JulienChagnon/C5VRX/README.md

<div align="center">
  C5VRX animated logo

  <p><strong>ESP32-C5 Analog 5.8 GHz FPV Receiver</strong></p>
  <p>From live 5.8 GHz FPV video to real-time analog CVBS with one Seeed Studio XIAO ESP32-C5 and a passive resistor DAC.</p>

  <p>
    
    
    
    
    
    
    
    
  </p>

  <p>
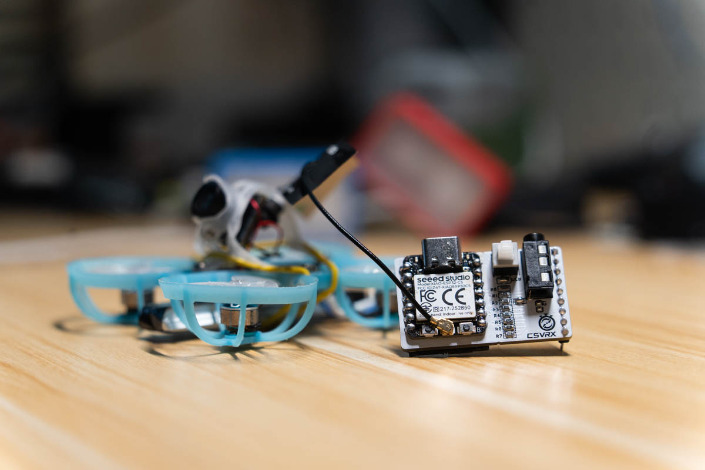
[picture p1: assets/C5VRX-1.jpg]
C5VRX receiver module with micro drone
    
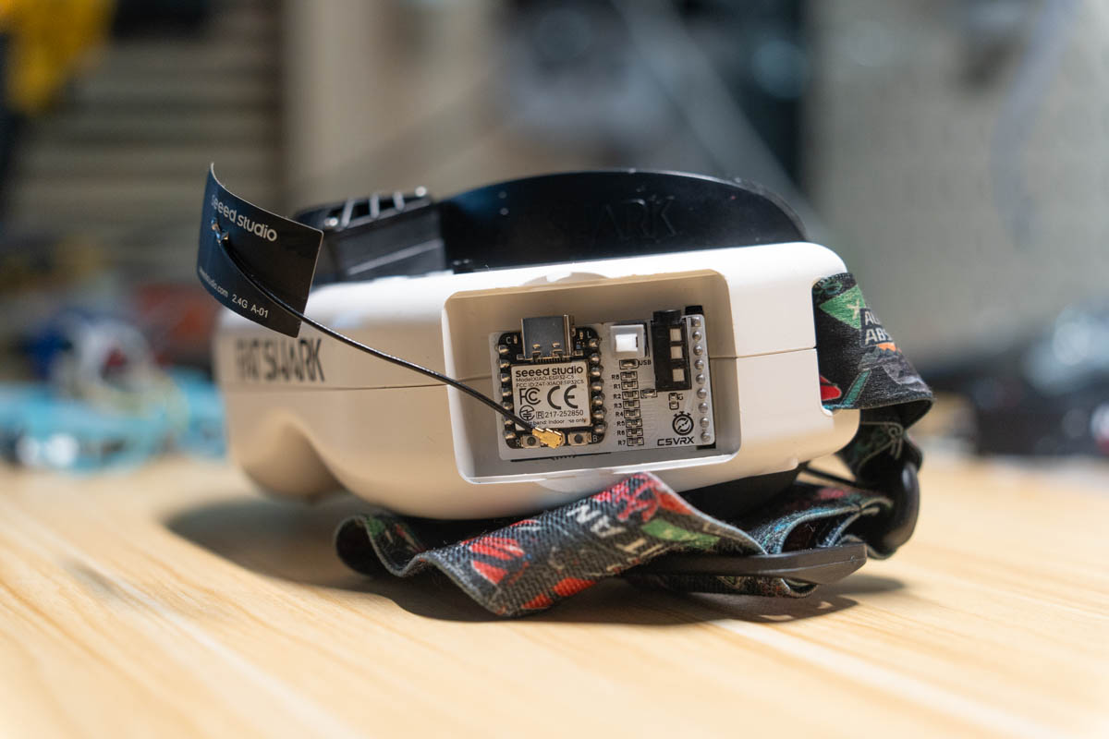
[picture p2: assets/C5VRX-2.jpg]
C5VRX receiver module installed in Fat Shark goggles
    
  </p>
</div>

---

C5VRX-5 receives analog 5.8 GHz FPV video using the ESP32-C5's own radio
and outputs composite PAL/NTSC through a passive 6-bit resistor DAC.
It includes automatic gain control, quick baseline boot and manual calibration, an on-screen menu
and browser-based flashing and controls. The sync flywheel was removed on
2026-10-25 (it caused severe desyncs and poor range on the board).

This branch builds and boots **U80P64-R1 only**. U85Q, kp/LP switching and
`m/K/k/j/P/O/H` controls are retired; see [P64 integration and evidence](docs/P64.md).
The fixed R1 table has one positive NTSC observation; PAL, weak-signal/range
and the final cleanup still need hardware validation. This default is an
operator choice, not a hardware qualification claim.

The PR #254 **11p receive baseline** is now applied at startup and after
channel/bandwidth/AFC restores, before measured analog profiles and digital
mode 0. In this branch calibration is manual; a quick boot phase check and
passive health monitor may recommend CALIBRATE. Upgrades can invalidate older
tables without starting an automatic calibration. The noise-only bench result is not a measured
sensitivity/range gain; see [11p integration and limits](docs/FINDINGS.md#11p-receive-baseline-pr-254-integration-2026-10-24).

## Experimental firmware — flight safety warning

> [!WARNING]
> **C5VRX is an experimental FPV receiver. Bugs, signal loss, automatic
> receive-chain changes or incompatibility with your camera/goggles can cause
> sudden loss of video or sync, even after an apparently successful test.
> Loss of FPV video can lead to a crash, property damage or serious injury.**
> Do not rely on C5VRX as your only means of maintaining safe control of an aircraft.

- **Test every new firmware version and hardware/settings combination on the
  ground first.** Remove propellers for bench tests. Check startup and
  calibration, weak-signal behaviour, recovery after video loss, and your actual
  camera/goggles. Complete calibration before takeoff.
- **Keep disruptive controls on the ground:** calibration, scanning, channel
  changes, menu entry/exit, DAC tests and diagnostics can interrupt or replace
  the live picture. Do not flash firmware or run bench tests during flight.
- **Automatic changes are experimental too.** Live filter/profile switching is
  currently documented as enabled by default and awaiting board validation.
  It restarts part of the receive chain and may interrupt video. Console
  `A` disables live profile switching (report-only mode); confirm the state
  with `T` on your build. Live OUTPUT, format and profile changes restart the pipeline. These settings do not establish flight safety.
- If you proceed to flight testing, use a controlled area clear of people,
  traffic and property, keep the aircraft close, and have a safe way to recover
  control if video disappears. Follow applicable local rules, including visual
  line-of-sight and observer requirements.
- **A versioned release, a “Latest” label or passing CI is not flight
  qualification.** Unmerged PR builds are development builds. Check the exact
  build's documented hardware and flight-test evidence; a test of an earlier
  build does not validate later changes.
- Report unexpected video loss with the exact firmware version/commit, hardware,
  settings, reproduction steps and any available logs/DVR footage. Preserve
  evidence after an incident, and investigate on the ground before flying again.

The firmware is provided under [GPL-3.0-only](LICENSE), including its warranty
and liability provisions in sections 15–17, to the extent permitted by
applicable law. This warning does not replace those terms or limit rights
that cannot legally be excluded.

## Video

[Watch the C5VRX-5 vs C5VRX-4 flight range test by Louis Hitchcock](https://www.youtube.com/watch?v=Gp3xmLrn_34).

## Hardware

XIAO ESP32-C5. DAC on D4..D9 (GPIO 23, 24, 11, 12, 8, 9; LSB first) with
8.2k / 3.9k / 2k / 1k / 470R / 240R and a 200R load, as in C5VRX-3/4
([schematic](docs/hardware/c5vrx-dac-schematic.png)). The
receiver uses the ESP32-C5's own Wi-Fi radio; no extra RF parts.

Other ESP32-C5 boards (Espressif DevKitC-1, Waveshare ESP32-C5-Pico, NiceMCU
ESP32-C5 Mini) have their own pin maps and images, and any other ESP32-C5
board can be flashed with its own pins from the web flasher's pin editor.
None of them is tested on hardware yet. The flasher draws each board with
the resistor for every pin. See [Boards](docs/BOARDS.md).

This development build moves the internal I-LSB loopback from D10/GPIO10
to the user-LED GPIO27, and the Q-sign loopback from D3/GPIO7 to GPIO2.
This reserves **D10 and D3 for future seventh/eighth DAC branches**. The LED
may glow during reception. No external IQ wiring is needed; the active DAC
remains 6-bit and the extra resistor footprints must stay **unpopulated (DNP)**.

| Reserved extra branch | XIAO pin / GPIO | Nominal resistor to CVBS | Future significance |
| --- | --- | --- | --- |
| Seventh branch | D10 / GPIO10 | 15 kOhm | 7-bit: bit 0; 8-bit: bit 1 |
| Eighth branch | D3 / GPIO7 | 33 kOhm | 8-bit: bit 0 (LSB) |

“Seventh/eighth” counts physical branches; these are added **low** bits,
not new MSBs. Existing D4..D9 branches become bits 1..6 for 7-bit or 2..7
for 8-bit. These are reserved footprints, not enabled output lanes or a
validated 7/8-bit resistor network. Wider output needs firmware and loaded
CVBS level/linearity checks. D3/GPIO7 is a boot strap: check reset loading
before populating its branch. GPIO2 is now IQ-owned and cannot also carry
the optional sample clock from PR #257. Both new IQ routes still require
board validation. The operator reported unsatisfactory behavior with the
LED-pin IQ route; this PR isolates it for comparison, not hardware acceptance.
See [the pin-routing findings](docs/FINDINGS.md#gpio27-iq-loopback-experiment-2026-10-25).

### Wiring the resistor DAC

Six resistors, one per XIAO pin, all joined on one node: that node is the
video output (CVBS). A seventh resistor from that node to GND is the load.

| XIAO pin | GPIO | DAC bit | resistor to the output node |
| --- | ---: | --- | ---: |
| D4 | 23 | bit 0 (LSB) | 8.2 kΩ |
| D5 | 24 | bit 1 | 3.9 kΩ |
| D6 | 11 | bit 2 | 2.0 kΩ |
| D7 | 12 | bit 3 | 1.0 kΩ |
| D8 | 8 | bit 4 | 470 Ω |
| D9 | 9 | bit 5 (MSB) | 240 Ω |
| GND | - | load | 200 Ω (output node to GND) |

```
D4 --[8.2k]--+
D5 --[3.9k]--+
D6 --[2.0k]--+
D7 --[1.0k]--+-----------> CVBS out (goggle / monitor AV-in, video)
D8 --[470R]--+     |
D9 --[240R]--+   [200R]   (optional: 470 pF from the node to GND,
                   |        improvement unproven)
GND ---------------+------> GND (goggle / monitor AV-in ground)
```

- The pin order matters: the largest resistor (8.2k) goes on D4 and the
  smallest (240R) on D9. A swapped pair gives a scrambled, banded picture.
- Connect the output node to the video input (centre/tip) of the goggles,
  a DVR or an analog monitor, and the XIAO GND to its ground. A common
  ground is required.
- All values are standard E24; 1 % metal-film resistors are fine. Keep
  the wires from the pins to the node short.
- Too dark or too dim on some goggles: try OUTPUT in the menu (0.5-5.0x,
  saved). Higher levels can clip; check the loaded output on your display.
- The XIAO is powered over USB-C or its 5 V pin as usual; the DAC needs no
  separate supply.
- **Check the build with the DAC self-test** before chasing picture
  problems: a test pattern for the goggles and a multimeter check that names
  a swapped, open or wrong resistor. See
  [Building and testing the resistor DAC](docs/hardware/dac-build-and-test.md).

### DIY Carrier PCB — REV C: Fat Shark Module + 3.5 mm AV Jack

**[C5VRX_JACK_DIY_V3 / REV C](hardware/C5VRX_JACK_DIY_V3)** is the latest proposed DIY carrier revision for the Seeed Studio XIAO ESP32-C5. It keeps the REV B layout (Fat Shark module-bay outline, 3.5 mm PJ-320D AV jack, reserved seventh/eighth DAC branches) and replaces the SJ1 bay-power solder bridge with a through-hole 1N5819 Schottky diode, so USB and the goggle bay can be connected at the same time.

<div align="center">
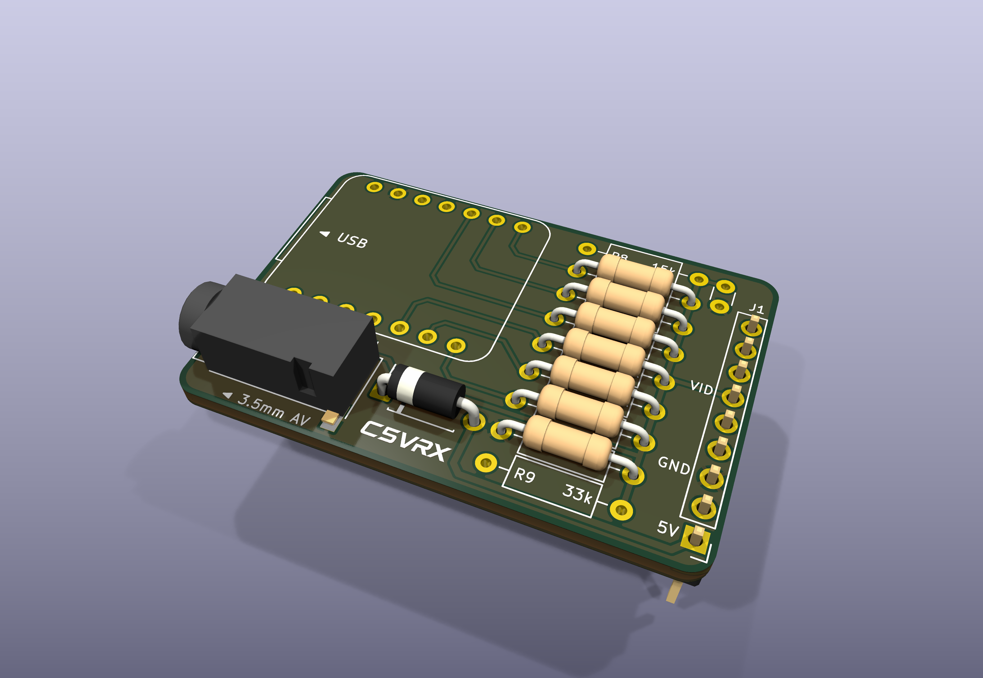
[picture p3: hardware/C5VRX_JACK_DIY_V3/exports/renders/01-front-perspective.png]
C5VRX REV C front with D1 power diode
  
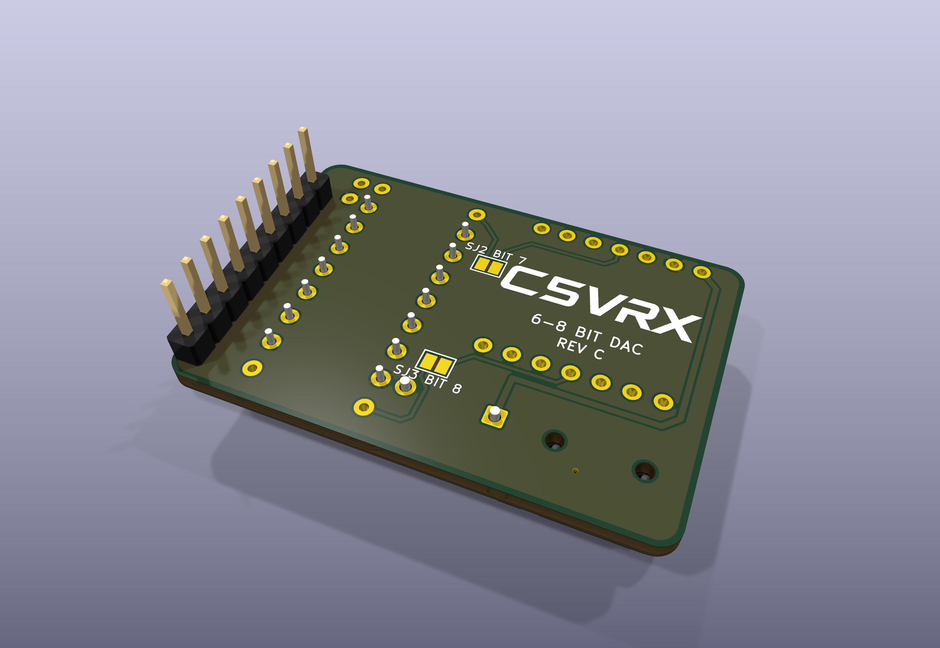
[picture p4: hardware/C5VRX_JACK_DIY_V3/exports/renders/02-back-perspective.png]
C5VRX REV C back with DAC jumpers
  
</div>

| Feature | REV C details |
| --- | --- |
| **Form factor** | 42.51 × 28.80 mm; XIAO, AV jack and bay header keep their REV A positions |
| **AV output** | VIDEO on Fat Shark J1 pin 6 and PJ-320D tip + ring 1; ground on the jack sleeve |
| **Through-hole DAC** | DIN0207 axial ¼ W resistors; existing six branches and 200 Ω shunt retained |
| **Reserved DAC expansion** | R8: 15 kΩ from D10/GPIO10 via SJ2; R9: 33 kΩ from D3/GPIO7 via SJ3 |
| **Bay power** | D1: 1N5819 Schottky (DO-41, through-hole) from bay 5 V to XIAO 5 V; no jumper to open before USB programming |
| **Rear solder jumpers** | SJ2 / BIT 7 and SJ3 / BIT 8: extra DAC branches |
| **Artwork** | C5VRX logos on both sides; REV C and 6–8 BIT DAC markings on the back |

**Current firmware remains six-bit:** leave R8/R9 unpopulated and SJ2/SJ3 open. The jumpers connect hardware only; seven/eight-bit output still needs matching firmware and electrical validation. [Assembly and jumper settings](hardware/C5VRX_JACK_DIY_V3#dac-branches-and-rear-jumpers).

**Downloads:** [Gerbers + drills](hardware/C5VRX_JACK_DIY_V3/exports/C5VRX_JACK_DIY_V3-gerbers.zip) · [KiCad project](hardware/C5VRX_JACK_DIY_V3) · [BOM](hardware/C5VRX_JACK_DIY_V3/BOM.csv) · [Schematic PDF](hardware/C5VRX_JACK_DIY_V3/exports/C5VRX_JACK_DIY_V3-schematic.pdf) · [STEP](hardware/C5VRX_JACK_DIY_V3/exports/C5VRX_JACK_DIY_V3.step) · [Renders](hardware/C5VRX_JACK_DIY_V3/exports/renders/).

KiCad ERC/DRC and schematic/PCB parity checks are clean; REV C has not been built or measured. [REV B](hardware/C5VRX_JACK_DIY_V2) and the original [REV A carrier](hardware/C5VRX_JACK_DIY) remain available with their fabrication files.

## Flashing

- **Browser:** open the [web flasher](https://twotoz.github.io/C5VRX/) in
  desktop Chrome or Edge, choose **C5VRX-5**, a build and your **Board**,
  connect, then flash. **Flash and PSRAM** on Auto picks the image from the
  connected chip (PSRAM if the chip has it, a 4 MB layout on 4 MB flash) and
  refuses an image that does not fit. It shows where each resistor goes on
  the selected board, and **Custom pins** writes other GPIOs into the
  image ([Boards](docs/BOARDS.md)).
  Use **Full firmware** when switching from another generation or image.
  Unmerged PR builds are marked as development builds.
- **From source:** use ESP-IDF **6.0.2**, run `idf.py build` in the
  repository root, then `python tools/flash.py PORT` (for example `COM6`
  or `/dev/ttyACM0`). Filter and DC correction require its exact libphy;
  other PHY versions disable them and produce a build warning.
  Do not use `idf.py flash` on a running receiver: its USB line reset hangs
  the board (pySerial "Write timeout") until USB and battery are removed.
  `tools/flash.py` asks the firmware for download mode with the `` ` `` key,
  flashes without a line reset and restarts through the watchdog. If the
  board is already in the ROM loader (BOOT held while plugging in), add
  `--no-key`. `--app-only` flashes only the app image, which is faster
  when the bootloader and partition table have not changed, and
  `--monitor` then shows the console without resetting the chip (use it
  instead of `idf.py flash monitor`; `--monitor-only` opens it without
  flashing). `--log FILE` keeps a timestamped copy of the console,
  `--iq DIR` saves each IQ snapshot (key `I`, or every N seconds with
  `--iq-every N`) as `.bin` + `.json`, and `--check` waits for the boot,
  runs `T` and `D` and exits 1 if the board crashed, runs a different
  image than the one flashed, or reports a chain fault (low heap only
  warns). Before flashing it warns when the build's `sdkconfig` differs
  from `sdkconfig.defaults`: ESP-IDF keeps an existing `sdkconfig`, so
  delete it and rebuild after the defaults change.
- **Local File** flashes your own `.bin`; **Legacy builds** contains archived
  C5VRX-3 firmware.

## XIAO PSRAM image

The standard image also supports boards without PSRAM. For a XIAO
ESP32-C5HR8 with 8 MB PSRAM, every release also has a PSRAM image, which the
web flasher picks on Auto. To build it with ESP-IDF 6.0.2:

```sh
idf.py -B build-psram -DSDKCONFIG=sdkconfig.psram "-DSDKCONFIG_DEFAULTS=sdkconfig.defaults;sdkconfig.psram.defaults" build
python tools/flash.py PORT --build build-psram --check
```

Use a fresh `sdkconfig.psram` when changing these defaults. Flash the full image
when switching configurations, including the matching bootloader. This image
requires PSRAM and will panic on a board without it. The contributor measured
boot `heap_min` rising from about 2.1 KB to 21.9 KB on the XIAO; PAL and long-run
checks remain pending. The live DMA/video buffers stay in internal RAM.
See [PSRAM measurements and limits](docs/FINDINGS.md#psram-8-mb-on-the-xiao-now-mapped-board-2026-10-26).

## First boot

1. Power the receiver: it loads saved values or a fixed baseline. A bounded
   sampling-phase check runs under the boot logo; no automatic RF/DC sweep.
2. If repeated measurements show a poor baseline, the menu shows a calibration
   recommendation. Use **CALIBRATE** on the ground, preferably with the VTX off.
   Menu calibration measures the current normal filter; **Full RF optimization**
   in the web controls is a separate, longer bench operation.
3. Select the VTX channel or use SCAN. Without a saved channel it starts on A1.
4. For multi-board testing, use **CALIBRATE → Download calibration report** in
   the connected web controls. This reads data without changing settings.
   See [measurement protocol and timing evidence](docs/FASTER_CALIBRATION.md).

## Controls (BOOT button)

| Action | Live video | Menu |
| --- | --- | --- |
| Short press | Next channel | Next item |
| Hold 0.6 s | Open menu | Select item |

The menu is one black-and-white settings list with every row in view:
**BAND**, **CHANNEL**, **SCAN**, **VIDEO** (AUTO/NTSC/PAL),
**CALIBRATE**, **OUTPUT** (0.5-5.0x), **GAIN** (AUTO/LEVEL/RSSI/MAX/fixed),
**DAC TEST** and **EXIT**, each with its current value. A card beside the
list keeps the frequency, signal and level in view and names what a hold
does. Every boot shows the C5VRX logo while Direct Gain finds its first
gain: the bar fills over 3 s (up to 4 s while the gain has not
held yet), so live video starts on a settled gain.
It closes after 30 seconds of
inactivity, or five minutes in DAC TEST. Menu transitions can interrupt video.
GAIN starts in AUTO (KEEL-1) on every boot. LEVEL and RSSI are research AGC
models for a side-by-side comparison on your own setup (docs/FINDINGS.md,
"AGC research"); they are simulated, not yet proven on the board.

## Serial console (USB, 115200)

Use the web flasher's **Terminal** tab for receiver controls and logs,
or a serial terminal at 115200 baud. Keys are case-sensitive and sent
without Enter; `h` lists the commands supported by your firmware.

| Key | Action |
| --- | --- |
| `T` / `h` | Status / help |
| `b` / `c` / `s` | Next band / next channel / scan |
| `o` / `n` / `x` / `e` | Open menu / next item / select / exit |
| `v` / `g` / `G` | Video standard / output level / gain |
| `F` / `B` / `C` | Calibrate current filter / full RF optimization / read-only calibration report |
| `Z` | DAC self-test (ground only) |
| `D` / `R` | Health report / per-second field diagnostics |
| `I` / `M` / `L` | IQ snapshot / gain map / bench IQ lane test |
| `A` | Live analog filter/profile switching on/off (saved) |
| `S` + suite | Bench PHY sensitivity lab, VTX on ([docs](docs/PHY_SENSITIVITY_LAB.md); ground only) |
| `` ` `` | USB download mode |

P64 always uses the same fixed program and LUT. Profiles select only the
analog filter (DEFAULT, NARROW or WIDE); old `kp_auto` and `lp_cn` settings
are ignored. `A` toggles experimental live profile switching (default on).
Live OUTPUT and profile changes share a five-second
cooldown and verified halted restart/rollback. Higher OUTPUT levels can clip.
GAIN always starts AUTO at boot; the OUTPUT preference is saved.
Check `T` after changing settings. Retired models remain research only.

The browser terminal and flasher use the port one at a time. **Download log**
saves the displayed output; only the latest 120,000 characters are retained.

## Documentation and development

- [DAC build and self-test guide](docs/hardware/dac-build-and-test.md)
- [REV C Fat Shark carrier PCB, power diode, jumpers and fabrication files](hardware/C5VRX_JACK_DIY_V3)
- [REV B carrier](hardware/C5VRX_JACK_DIY_V2)
- [REV A carrier archive](hardware/C5VRX_JACK_DIY)
- [Receiver findings and hardware evidence](docs/FINDINGS.md)
- [Field-test protocol](docs/FIELD_TEST.md)
- [Current receiver changes and validation](docs/PR212.md)
- [U85Q research](docs/pr190-key-findings.md) and [research index](research/README.md)
- [Contributing](CONTRIBUTING.md)

`main/` contains C5VRX-5 firmware, `web/` the GitHub Pages flasher,
`test/` host tests, `docs/` guides and findings, `research/` experiments,
and `tools/` console and CI helpers. `legacy/` preserves C5VRX-1 through
C5VRX-4 as reference; they are not built.

CI runs host/research checks and builds firmware with ESP-IDF 6.0.2.
Firmware changes publish versioned `c5vrx5-v5.0.N` releases or unmerged
`c5vrx5-pr-N` builds. Website-only changes do not create firmware releases.
Pages deploys the website from `main` with a same-origin firmware mirror.
Firmware PRs need passing checks and board tests on the matching artifact;
host tests alone do not establish picture compatibility or RF range.

## Community

Share build photos, questions and feedback on the
[C5VRX Discord](https://discord.gg/3YNgJRHmzD).

## Credits and license

C5VRX-5 is part of [C5VRX](https://github.com/Twotoz/C5VRX) by Twotoz and
the C5VRX contributors; the official website
([twotoz.github.io/C5VRX](https://twotoz.github.io/C5VRX/)) has the project
and its Discord invite. It builds on C5VRX-2..4 (the continuous MODEM_DIAG
to BitScrambler video path, Direct Gain V3-V5, the PAIR schedule and the
U85Q study of PR #190), on zerowidth/C5VRX PR #3 (interference-burst gate,
sampling-phase probe, off-grid channel tuning), on Louis Hitchcock's staged
overload recovery (C5VRX #182/#184), and on ESPARGOS esp-sdr (GPL-3.0) for
the C5 RX filter control. Espressif supplied the GDMA EOF fix
(espressif/esp-idf#19091).

Like the rest of this repository, C5VRX-5 is licensed under
**GPL-3.0-only** (see [LICENSE](LICENSE)). The GPL allows
commercial use, including selling receivers with this firmware, provided
the source (with your changes) is passed on under the same license.

The C5VRX name and logos have separate terms; see [assets/BRANDING.md](assets/BRANDING.md).

## Build components

| Product | Photo | Link / Source |
| --- | --- | --- |
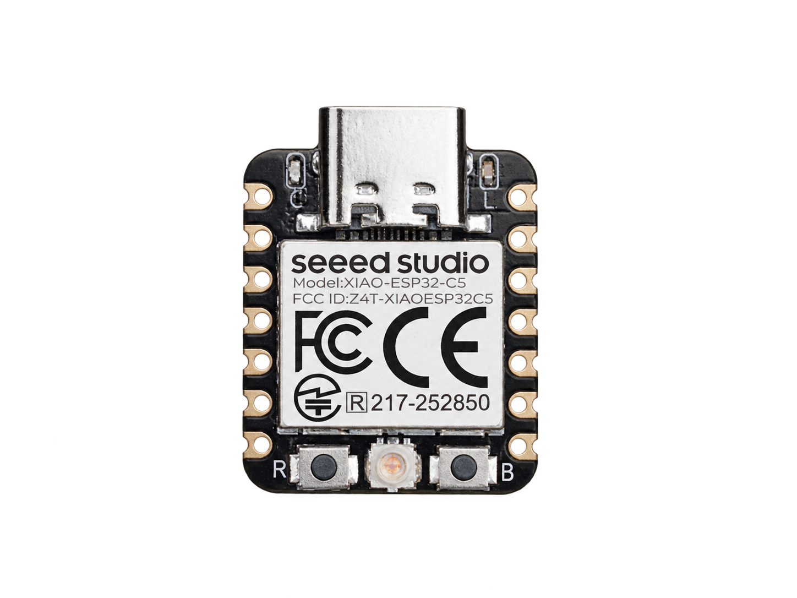
[picture p5: web/assets/xiao-esp32c5.png]
Seeed Studio XIAO ESP32-C5 board
| Seeed Studio XIAO ESP32-C5 |  | [View on Amazon](https://link.amazon/B0gopCVDt) |
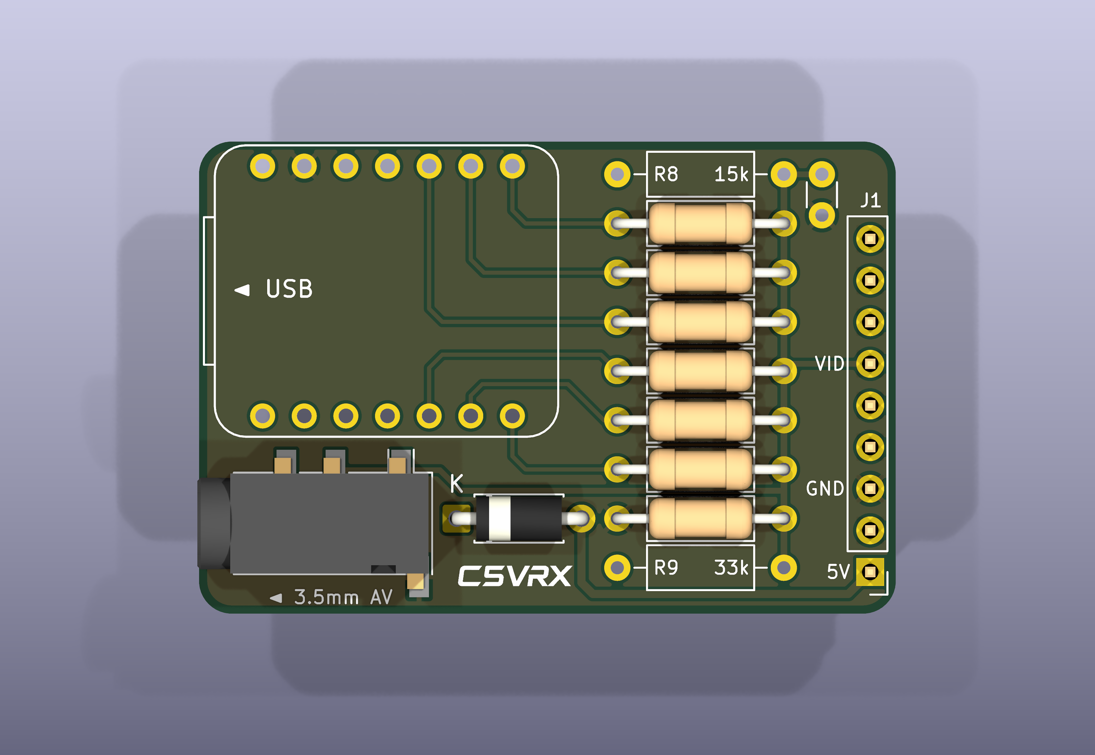
[picture p6: hardware/C5VRX_JACK_DIY_V3/exports/renders/03-front-straight.png]
C5VRX REV C PCB render
| C5VRX_JACK_DIY_V3 / REV C carrier |  | [Gerbers & KiCad files](hardware/C5VRX_JACK_DIY_V3) · [REV B](hardware/C5VRX_JACK_DIY_V2) · [REV A](hardware/C5VRX_JACK_DIY) |
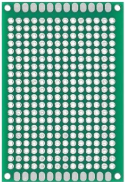
[picture p7: web/assets/perfboard.png]
Green perfboard
| Perfboard (alternative) |  | [View on Amazon](https://link.amazon/B0i2qqMeq) |
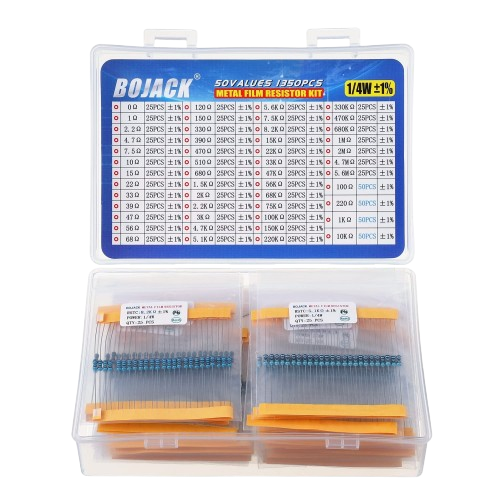
[picture p8: web/assets/resistor-kit.png]
Resistor assortment in a storage case
| Resistor kit |  | [View on Amazon](https://link.amazon/B06XSBkln) |

Affiliate links. As an Amazon Associate, I earn from qualifying purchases.
All affiliate earnings go back into C5VRX development.
