JulienChagnon/C5VRX/hardware/C5VRX_JACK_DIY_V3/exports/renders/README.txt

C5VRX_JACK_DIY_V3 REV C
3200 x 2200 px native KiCad raytraced renders.

XIAO module: no 3D model supplied; its mounting outline is visible.
R8/R9 and C1 are DNP and are deliberately absent in the renders.
SJ2/SJ3 are open solder jumpers on the back; D1 (1N5819) is fitted on the front.
