JulienChagnon/C5VRX/assets/BRANDING.md

# C5VRX branding

The C5VRX name, logo, `assets/c5vrx-logo.jpg`,
`assets/c5vrx-phase8-logo.png`, `assets/c5vrx-white-logo.png` (and the boot
logo `main/menu_logo.h` generated from it), distinctive visual identity and other project
branding are not licensed under the GNU General Public License.
The `GPL-3.0-only` grant applies to the repository-authored software and other
covered material, not to trademark or branding rights.

No permission is granted by the software license to use C5VRX branding for a
modified or unrelated product, to suggest that a derivative is an official
C5VRX release, or to imply sponsorship or endorsement. Separate permission
from the applicable rights holder is required except where use is otherwise
permitted by law, such as accurate descriptive or nominative reference.

Third-party names and marks, including Espressif and ESP-IDF, belong to their
respective owners and are subject to their own policies.
