JulienChagnon/C5VRX/hardware/C5VRX_JACK_DIY/exports/C5VRX_JACK_DIY-schematic.pdf

1 | 2 | 3 | 4 | 5 | 6
1 | 2 | 3 | 4 | 5 | 6

AB

C

D

AB

C

## D Date:

Size: A4 | Rev:
KiCad E.D.A. 10.0.6 | Id: 1/1

# Title:

## File: C5VRX_JACK_DIY.kicad_sch

## Sheet: /

~ 1

~ | 2 D0_/_GPIO1 | R4 | 1k 1 | D1_/_GPIO0 2 | D2_/_GPIO25 3 | D3_/_GPIO7 4 | D4_/_GPIO23 | 5 D5_/_GPIO24 | 6 D6_/_GPIO11 | 7 D7_/_GPIO12 | 8 D8_/_GPIO8 | 9 D9_/_GPIO9 | 10 D10_/_GPIO10 11
3V3 12 | GND 13
5V 14 | U1
XIAO ESP32-C5

~ 1 #FLG02
SUPPLY

~ 1

~ | 2 R1 | 8.2k

~ 1 #FLG01
SUPPLY

~ 1

~ | 2 R6 | 240

~ 1

~ | 2 R7 | 200

~ 1 #FLG03
SUPPLY

~ 1

~ | 2 R3 | 2k | 5V 1 | RSSI 2 | GND 3
AUDIO_R 4

AUDIO_L 5

VIDEO 6 | B2 7 | B1 8 | B0 9

J1
FATSHARK BAY

~ 1
~ 2 C1
470pF | R1R2

S

T

J2 PJ-320D

~ 1

~ | 2 R2 | 3.9k

~ 1

~ | 2 R5 | 470

~ 1

~ | 2
SJ1 | 5V LINK

DAC4

5V_BAY 5V_XIAO | GND

VIDEO

GND

5V_XIAO | VIDEO VIDEO

5V_BAY

VIDEO

GND

5V_XIAO | DAC0 GND | DAC1

VIDEO

VIDEO

VIDEO

# DAC5 DAC3 DAC2

VIDEO

VIDEO

VIDEO | GND

VIDEO

5V_BAY GND SJ1: solder bridge for bay power. Open SJ1 before USB programming. XIAO BOOT button controls the firmware menu. R1..R7: axial through-hole, DIN0207 / 0.25W, 10.16 mm lead pitch. XIAO: plug-in mounting on 2 x 7-pin headers. Decoupling is provided on the XIAO module. | C1: OPTIONAL / DNP. 470 pF C0G/NP0, only if needed. Check loaded video before fitting.

Only 5V, GND and VIDEO connected at the goggle bay. D4..D9 = DAC bit 0..5. Use XIAO firmware pin mapping. R1..R7: upstream C5VRX-5 values, 1% recommended.

LOCAL FIRMWARE BOM OPTION (same PCB): R1 7.87k, R2 3.92k, R3 1.96k, R4 976, R5 487, R6 243, R7 191. Choose one complete DAC set to match the firmware. No extra 75-ohm shunt. | PJ-320D / 3.5 mm AV (TRS / TRRS) Tip + Ring 1 = VIDEO

Sleeve = GND; Ring 2 = N/C C5VRX_JACK_DIY / FAT SHARK DOMINATOR + 3.5MM AV - XIAO THT CARRIER

J1: pin 1 = bottom / 5V; pin 9 = top. Component side: header RIGHT, USB LEFT. Unused bay pins intentionally unconnected.
