JulienChagnon/C5VRX/web/assets/c5vrx-diy-kit-top.webp

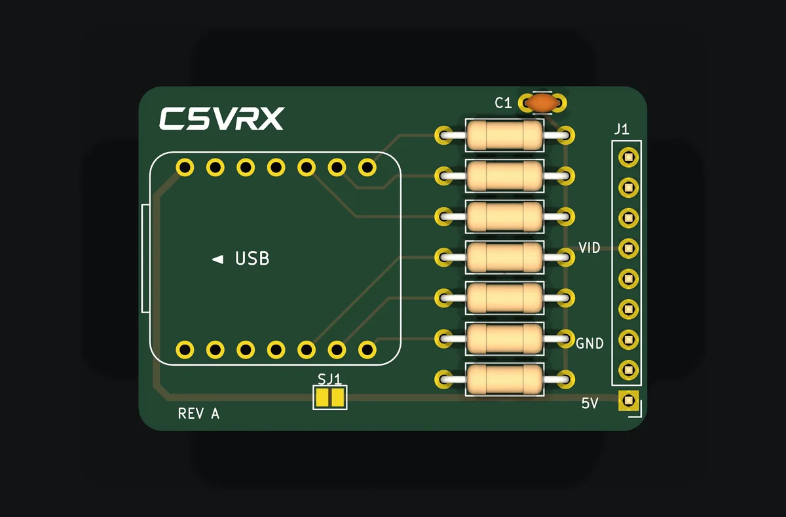
web/assets/c5vrx-diy-kit-top.webp
