JulienChagnon/C5VRX/web/assets/c5vrx-diy-kit.jpg

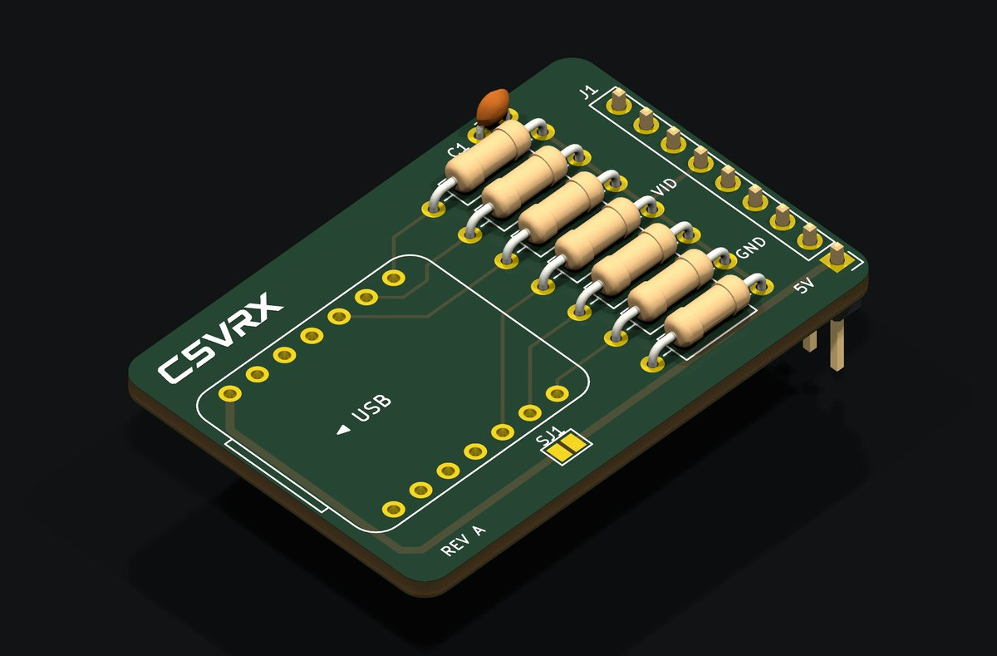
web/assets/c5vrx-diy-kit.jpg
