JulienChagnon/C5VRX/hardware/C5VRX_JACK_DIY_V3/BOM.csv

Reference | Value | Footprint | Quantity | Populate | Note
C1 | 470pF | Capacitor_THT:C_Disc_D3.0mm_W1.6mm_P2.50mm | 1 | DNP
D1 | 1N5819 | C5VRX:D_DO-41_P7.62mm_Horizontal_Compact | 1 | YES | Schottky 1 A / 40 V (DO-41); 1N5817 also fits; band (cathode) toward the K mark
J1 | FATSHARK BAY | C5VRX:FatShark_Header_1x09 | 1 | YES
J2 | PJ-320D | Connector_Audio:Jack_3.5mm_PJ320D_Horizontal | 1 | YES
R1 | 8.2k | Resistor_THT:R_Axial_DIN0207_L6.3mm_D2.5mm_P10.16mm_Horizontal | 1 | YES
R2 | 3.9k | Resistor_THT:R_Axial_DIN0207_L6.3mm_D2.5mm_P10.16mm_Horizontal | 1 | YES
R3 | 2k | Resistor_THT:R_Axial_DIN0207_L6.3mm_D2.5mm_P10.16mm_Horizontal | 1 | YES
R4 | 1k | Resistor_THT:R_Axial_DIN0207_L6.3mm_D2.5mm_P10.16mm_Horizontal | 1 | YES
R5 | 470 | Resistor_THT:R_Axial_DIN0207_L6.3mm_D2.5mm_P10.16mm_Horizontal | 1 | YES
R6 | 240 | Resistor_THT:R_Axial_DIN0207_L6.3mm_D2.5mm_P10.16mm_Horizontal | 1 | YES
R7 | 200 | Resistor_THT:R_Axial_DIN0207_L6.3mm_D2.5mm_P10.16mm_Horizontal | 1 | YES
R8 | 15k | Resistor_THT:R_Axial_DIN0207_L6.3mm_D2.5mm_P10.16mm_Horizontal | 1 | DNP | Leave empty with PR259 firmware; future DAC branch
R9 | 33k | Resistor_THT:R_Axial_DIN0207_L6.3mm_D2.5mm_P10.16mm_Horizontal | 1 | DNP | Leave empty with PR259 firmware; future DAC branch
SJ2 | BIT 7 | Jumper:SolderJumper-2_P1.3mm_Open_Pad1.0x1.5mm | 1 | OPEN | Rear PCB solder bridge; no purchased component; default OPEN
SJ3 | BIT 8 | Jumper:SolderJumper-2_P1.3mm_Open_Pad1.0x1.5mm | 1 | OPEN | Rear PCB solder bridge; no purchased component; default OPEN
U1 | XIAO ESP32-C5 | C5VRX:XIAO-ESP32-C5-DIP | 1 | YES
