JulienChagnon/C5VRX/hardware/C5VRX_JACK_DIY_V3/exports/C5VRX_JACK_DIY_V3.step

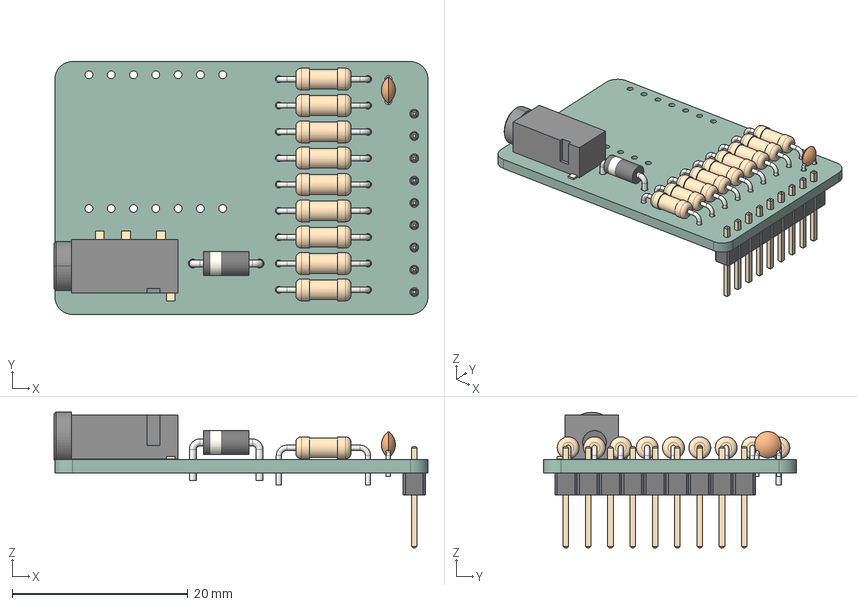
[picture p16: CAD file, 2026-10-25]
hardware/C5VRX_JACK_DIY_V3/exports/C5VRX_JACK_DIY_V3.step
42.6 x 28.8 x 15.4 mm
R_Axial_DIN0207_L63mm_D25mm_P1016mm_Horizontal x 9
PJ-320D-A
C_Disc_D30mm_W16mm_P250mm
PinHeader_1x09_P254mm_Vertical
D_DO-41_SOD81_P7.62mm_Horizontal
C5VRX_JACK_DIY_V3_PCB
