JulienChagnon/C5VRX/hardware/C5VRX_JACK_DIY_V3/PJ-320D.step

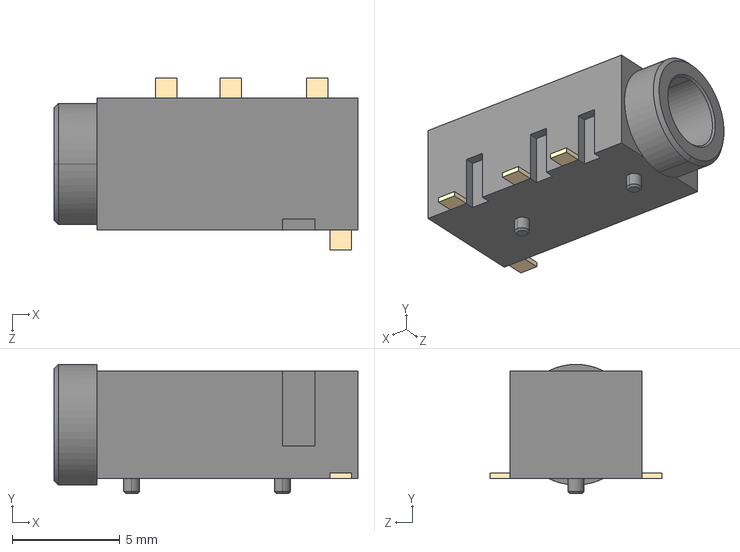
[picture p17: CAD file, 2026-10-24]
hardware/C5VRX_JACK_DIY_V3/PJ-320D.step
14.1 x 6.00 x 8.00 mm
