JulienChagnon/C5VRX/hardware/C5VRX_JACK_DIY/exports/C5VRX_JACK_DIY.step

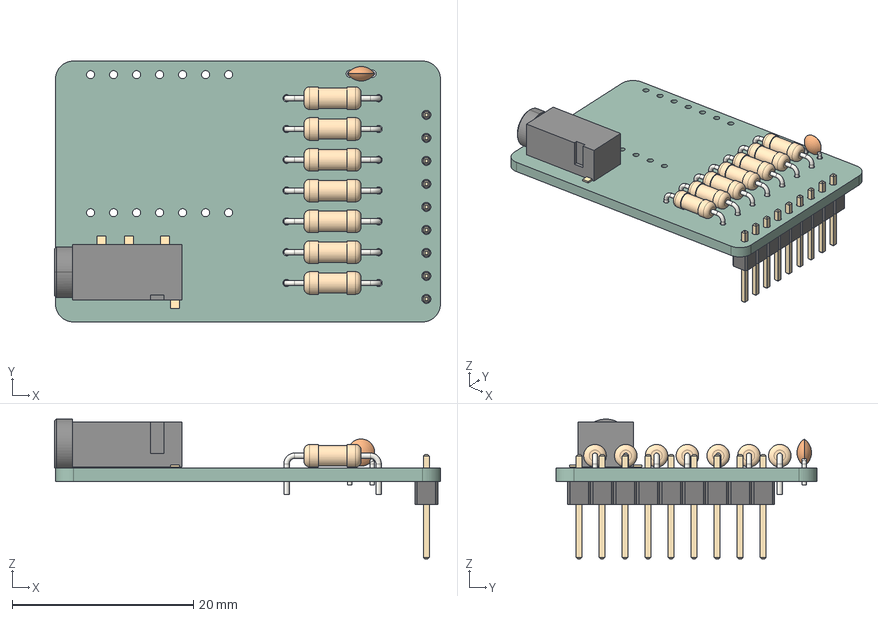
[picture p18: CAD file, 2026-10-24, an earlier design]
hardware/C5VRX_JACK_DIY/exports/C5VRX_JACK_DIY.step
42.6 x 28.8 x 15.4 mm
PJ-320D-A
R_Axial_DIN0207_L63mm_D25mm_P1016mm_Horizontal x 7
C_Disc_D30mm_W16mm_P250mm
PinHeader_1x09_P254mm_Vertical
C5VRX_JACK_DIY_PCB
