JulienChagnon/C5VRX/hardware/C5VRX_JACK_DIY_V2/exports/C5VRX_JACK_DIY_V2.step

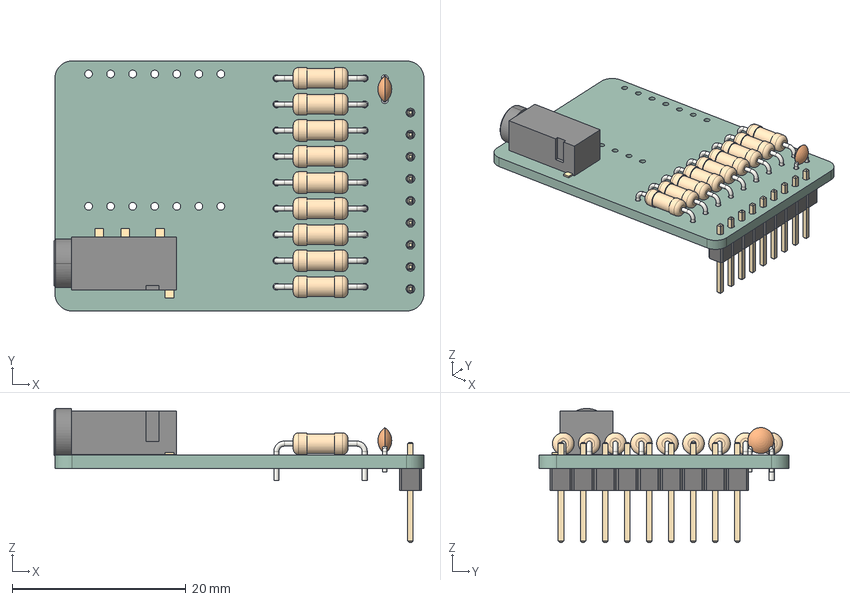
[picture p19: CAD file, 2026-10-25, an earlier design]
hardware/C5VRX_JACK_DIY_V2/exports/C5VRX_JACK_DIY_V2.step
42.6 x 28.8 x 15.4 mm
R_Axial_DIN0207_L63mm_D25mm_P1016mm_Horizontal x 9
PJ-320D-A
C_Disc_D30mm_W16mm_P250mm
PinHeader_1x09_P254mm_Vertical
C5VRX_JACK_DIY_V2_PCB
