JulienChagnon/C5VRX/docs/FASTER_CALIBRATION.md

# Baseline boot and manual calibration

C5VRX by Twotoz and the C5VRX contributors. PR #272 extends the startup
calibration, exact-context DC tables and phase diagnostics, with the operator's
updated policy: boot quickly, warn on real poor performance, calibrate on request.

## What happens at boot

- Load matching saved filter/DC values, otherwise use a fixed filter preset
  (BW40, code 16, skirt 32). This preset is a starting configuration, not a
  claim of measured 12 MHz on every board.
- DC base map in the firmware (operator decision 2026-10-26): with the baseline
  filter, the gain rows this board has no codes for are filled from
  `main/dco_preset.h` (median codes per gain of measured boards, generated by
  `tools/dco_preset.py` from F + C reports, VTX off) as template rows instead
  of the chip's own DC. Other filters or contexts keep the chip's DC. Built
  from one board so far (b26ef545, nine F runs over three boot sessions);
  rebuild it from more boards. Within a session F runs agreed to ~1 code per
  row; between sessions the high-gain Q codes moved by 10-15 codes (~1-2
  cells at G80-G83; cause unproven, possibly per-reset sampling alignment),
  which is what the live servo below corrects.
- Do not sweep filters, search DC, build a gain/noise map or wait for a VTX.
  Existing gain control and AFC remain active.

## Live DC servo (operator decision 2026-10-26)

Every held row (own, template or base map) is tuned live by the per-row DC
servo of main (`dc_servo.h`, restored as `servo_service()`), with the VTX on
or off and without stopping video: the mean of every settled observer probe
of a row, a computed step on both DAC codes, folding-safe sign-share logic,
trim limits of +-96 codes (own rows) and +-192 (template/base map). Board
result on main (2026-10-19/20): 0.3-0.8 cells after 60 s on six boots and a
2-4 dB range limit against 2-8 dB without. A template or base-map row the
servo holds within 0.3 cells for 8 estimates on receiver noise, or 16 on a
carrier, becomes this channel's own row and is stored, so the next boot starts
closer. Boot itself still runs no search or trim.

The servo corrects only on a settled sampling phase. Board 2026-10-26, b26ef545,
VTX off: one boot in five came up with the phase unverified after the boot
check (`SPHASE ... excess_mc2=1883 limit=300`, the boot scan read `worst=5076`).
On mixed IQ bits every mean is noise of its own, and the servo walked I to its
-96 limit with the IQ fully clipped (`clipped_pm=1000`); on the four settled
boots it held 0.26-0.37 cells from starts up to 1.65 cells. An unsettled phase
holds the servo (and forgets its steps). Its RAM: the servo state is 36 rows in
LP RAM; 5.2 KB more static HP RAM left the USB console silent from boot.

## Live sampling-phase repair (operator decision 2026-10-26)

Current bench key: `!` performs one RX slip. PR #273 reserves `S` plus a
suite key for the PHY sensitivity lab; the historical `S` logs below
predate that key change.

Bench with console `S` (one RX slip) on b26ef545, VTX off: 3 of 12 positions
read mixed IQ bits (excess 4588-6597 against 44-62, IQ 989-998 per mille
clipped, no usable picture). The bad phase causes the clipping on its own; the
servo only made run 2 worse before its phase gate. The boot check aligns once
under the splash, and nothing repaired a phase found wrong afterwards. Now
`phase_service()` runs the existing confirmed scan (three, then nine positions,
ending on the cleanest) after three consecutive monitor blocks at excess >= 1500,
at most every 10 s, backing off 30 s doubling to 16 min after a failed scan
(`SPHASE live_repair ...`). It pauses gain control for the scan; video keeps
running. A phase still unsettled is reported as `CAL_NEEDED reason=sampling_phase`.

Calibration is recommended only where the servo cannot do it: at its trim
limit, without a held row, after a write fault, or when the DC stays above
1.5 cells for 30 s of qualified evidence on the channel and filter
(`cal_persist_add`, `CAL_NEEDED reason=dc_servo_limit|dc_servo_failed`).
F remains the full own-row calibration; B the full RF optimization.
- Sampling alignment is the sole small boot exception: per-reset timing can
  corrupt IQ, so two 24-window clean observations can qualify it; otherwise
  try three positions with repeated confirmation. The collector has a 600 ms
  deadline, no nine-position retry, and runs only under the existing splash,
  at most once in the first five seconds. A result that cannot be proved within
  the budget remains unknown; the live repair above can subsequently recover
  a persistently bad phase. Manual CALIBRATE remains available.
- Share passive DC/noise/phase measurements at no more than four blocks/second.
  Three stable, independent, qualified blocks are required before recommending
  calibration. Noise must look like noise; a carrier needs a qualified circle
  and recent real video. Missing tables, insufficient samples, low-gain fixed
  points, isolated spikes and a high phase metric alone do not prove a bad map.
  Gaps and context changes reset evidence. DC above 1.5 cells or repeated filter
  readback failure can warn; good evidence clears the warning.
- Show the recommendation in the existing splash (no extra warning screen),
  on the menu CALIBRATE item and in USB/web status. Never take over live video
  merely to display an automatic warning. Unknown is not a pass or a fault.

The normal logo is still 3-4 seconds and can finish earlier near an overall
9-second application deadline, leaving handover margin for a 10-second target.
`BOOT_TIMING radio_ms=...` / `ready_ms=... target_ms=10000` measure the real
application timing. Vendor radio initialization, a stalled driver and hardware
failures cannot be made into a guaranteed sub-ten-second boot by this code;
check the actual end-to-end timing on the boards. The bounded phase work runs
inside the existing splash rather than adding a separate calibration phase.

## Explicit controls

- Menu **CALIBRATE** / console **F**: measure/repair the default filter's gain
  rows, characterize this one filter on noise, share DC verification windows
  with its noise map, and do full phase qualification. No 130-setting grid or
  other filter-profile DC tables. VTX off is needed to measure all gains.
- Console **B** / web **Full RF optimization**: explicit exhaustive-option run,
  including the filter grid, DC for all distinct filter profiles and VTX
  measurement; allow up to eight minutes. Live video is interrupted.
- A VTX-on DC run can qualify the actual current carrier row only. Never
  label DC measured on another channel as this channel's own correction.
- Live profile switching starts report-only on every boot; a saved preference
  cannot enable it. Console A can explicitly opt in for that session, and
  existing DC readiness/quality/transport guards still apply.

Manual DC uses own/nearby starting values, short search probes, a full 64-window
independent check and full-search fallback. A centred prediction avoids response
probes. Flat rows grow local brackets but retain adjacent-code bisection and
both cross-coupling rounds. One gain owner covers a DC batch, avoiding a pause
and gain restore for every row. Board-proven settling and IDLE yields remain.
F/B never relax existing row rejection or silently turn a template into own data.

## Read-only report for board testing

Connect via USB in the web flasher, open **CALIBRATE**, optionally enter a board
name, VTX state and notes, and click **Download calibration report**. Send the
resulting JSON file to Leon. Console **C** requests the same firmware dump.
No report request starts calibration, changes a channel/filter/gain, or captures
raw IQ. It works before calibration as well: absent observations stay unknown.

The report includes a stable pseudonymous board ID (same hash as the flight
log, not the MAC), exact firmware/IDF/chip revision, current context and health,
measured filter widths/NBW, active and stored per-channel/filter DC rows with
valid/template flags, gain values/confidence/uncertainty, available noise rows,
boot/manual timings and whether the live context changed during the read.
Sequence numbers, total record count and FNV-1a verify transfer completeness;
partial/corrupt/unsupported reports are never downloaded as valid data. Reading
is paced, uses bounded records, and leaves the video dataplane running.

For each labelled board, collect:

1. VTX off, cold boot, download a **before F** report; record `BOOT_TIMING`.
2. Run menu CALIBRATE/F, let it finish, download **after F**.
3. Cold boot again and download **reboot after F**. Repeat several boots and
   channels, keeping power supply and antenna documented.
4. Optionally run B for filter optimization research and collect its report
   separately. Do not mix B's optimized filter with the default preset group.
5. Repeat with known VTX/camera and PAL/NTSC, recording actual video/weak-signal
   behaviour separately. A report is not an RF-range or goggle compatibility test.

When creating a population baseline, group by physical board, firmware/calibration
generation, frequency, IQ scale and complete filter setting. Exclude invalid,
template and unstable/unqualified rows. Active/saved duplicates and repeated
captures of one board count as one board, not extra independent boards.
Compare full filter presets; do not take independent medians of register fields.
DC/gain priors require per-board validation and holdout boards before shipping.
No fabricated multi-board median is included: `GAIN_MAP_PRESET_BOARDS` remains
zero until real measured maps are supplied.

## Speed comparison with main

`python3 tools/calibration_benchmark.py --base origin/main` compiles and executes
both revisions' actual DC search functions against a deterministic mock PHY.
It reports scheduled waiting only, not C5 CPU time or RF quality. The checked-in
result is `research/data/calibration_timing_model.json`:

| Case | Main waits | PR waits | Ratio |
| --- | ---: | ---: | ---: |
| Already centred seed | 534 ms | 260 ms | 2.054x |
| Coupled I/Q correction | 712 ms | 506 ms | 1.407x |
| Flat local bracket | 1092 ms | 676 ms | 1.615x |

Both versions reach identical residuals in these mock cases. Normal boot removes
all automatic RF sweeps/DC searches and VTX arrival waits; these ratios describe
manual search internals, not total boot. F also skips the 130-setting search and
up to two extra DC tables compared with main's F, but actual total speedup needs
hardware `BOOT_TIMING`, `CAL_MANUAL` and `CAL_STEP` logs. There is no numerical
whole-calibration/range claim without those measurements.

## Board result: low-gain DC gate (2026-10-26)

One board (b26ef545), A1 5865 MHz, VTX off, video output proven not to raise
the floor (console N: +0.11 dB on vs off). With 1ce49d0 every F stopped the DC
batch at G68..G73 as `carrier_detected`, leaving 14-15 low-gain rows missing
and the stop row varying per run. Gate log: `reason=envelope env_x100=122`
at G69. Receiver noise of a few quantizer steps lifts the envelope statistic
above the quiet limit (1.15) or reads `origin`; it is not a carrier. The DC
batch and row repair now stop only on a definite carrier, the filter sweep's
rule (`cal_dc_gate_carrier`; a carrier still stops it from ~2 dB C/N in the
host model). Result over three F runs: 30/30 rows (`result=done`), pooled
code std I 0.81 / Q 0.83 (was 1.30 / 0.90 over the partial maps), measured
width 13125 kHz each run, F 32-37 s (more rows measured). One board only;
no range claim. Uncalibrated, this board showed 3.7/1.7 cells live DC at G83
before F.

## Live repair bench follow-up (2026-10-26)

Board b26ef545, local `5.0.0-repair1+local` build (reported ELF prefix
`6bd0fe939`), A1. The initial 12-slip noise run recorded a successful automatic
repair from excess 3995 to 34, 2.56 s after the preceding S acknowledgment.
A second bad position fell within the success cooldown; the next manual slip
cleared it, so that occurrence is not evidence of automatic recovery.

A further 12-slip run used 12-second waits before each status request, with
an NTSC carrier present initially and changing RF conditions during the run.
It recorded multiple successful automatic repairs and ended at excess 61,
clipping 0 per mille and no transport faults after a further 15 seconds.
One repair was logged 9.60 s after the preceding slip: neither the monitor
nor its cooldown provides a two-second upper bound. USB receipt times include
buffering; these are not hardware timestamps or a video interruption measure.

Captured observations and source-log hashes are in
`research/data/phase_repair_bench_2026-10-26.json`. This is one-board bench
evidence, not a range test or validation of every phase/carrier context. The
local build reports `commit=local`; the final merged source is separately
checked by host tests and the ESP-IDF CI build.
