JulienChagnon/C5VRX/research/data/p64_lowcn_original_grid/validation.csv

standard | deviation | C/N (dB) | model | SINAD (dB) | Line sync (%)
PAL | 0.7 | -10.0 | U85Q | -10.118652938345672 | 0.0
PAL | 0.7 | -10.0 | U80P64-R1 | -8.53917682898217 | 0.0
PAL | 0.7 | -10.0 | P64-LowCN-E2 | -8.07227249669345 | 0.0
PAL | 0.7 | -8.0 | U85Q | -10.294828553906365 | 0.0
PAL | 0.7 | -8.0 | U80P64-R1 | -11.129774467447252 | 0.0
PAL | 0.7 | -8.0 | P64-LowCN-E2 | -11.221441219434464 | 0.0
PAL | 0.7 | -6.0 | U85Q | -9.261284965305489 | 0.0
PAL | 0.7 | -6.0 | U80P64-R1 | -9.647637911360938 | 0.0
PAL | 0.7 | -6.0 | P64-LowCN-E2 | -9.92400653426144 | 0.0
PAL | 0.7 | -4.0 | U85Q | -8.586236244066201 | 0.0
PAL | 0.7 | -4.0 | U80P64-R1 | -8.863358452540645 | 0.0
PAL | 0.7 | -4.0 | P64-LowCN-E2 | -9.143152949403406 | 0.0
PAL | 0.7 | -3.0 | U85Q | -8.016136296777614 | 6.143344709897611
PAL | 0.7 | -3.0 | U80P64-R1 | -8.41055920504688 | 9.621993127147768
PAL | 0.7 | -3.0 | P64-LowCN-E2 | -8.676161099206519 | 17.921146953405017
PAL | 0.7 | -2.0 | U85Q | -7.112363019820788 | 18.771331058020476
PAL | 0.7 | -2.0 | U80P64-R1 | -7.717141915623151 | 30.181818181818183
PAL | 0.7 | -2.0 | P64-LowCN-E2 | -7.922129067943194 | 22.62773722627737
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
