JulienChagnon/C5VRX/research/data/p64_lowcn_search/validation.csv

standard | deviation | C/N (dB) | model | SINAD (dB) | Line sync (%)
PAL | 0.7 | -10.0 | U85Q | -10.079564509598347 | 0.0
PAL | 0.7 | -10.0 | U80P64-R1 | -8.488580628689853 | 0.0
PAL | 0.7 | -10.0 | P64-LowCN-E1 | -8.128861850059222 | 0.0
PAL | 0.7 | -8.0 | U85Q | -10.276915549567846 | 0.0
PAL | 0.7 | -8.0 | U80P64-R1 | -11.101938200512372 | 0.0
PAL | 0.7 | -8.0 | P64-LowCN-E1 | -11.211320540464202 | 0.0
PAL | 0.7 | -6.0 | U85Q | -9.245706816160002 | 0.0
PAL | 0.7 | -6.0 | U80P64-R1 | -9.624829850388366 | 0.0
PAL | 0.7 | -6.0 | P64-LowCN-E1 | -9.965910374563597 | 0.0
PAL | 0.7 | -4.0 | U85Q | -8.58617638206389 | 0.0
PAL | 0.7 | -4.0 | U80P64-R1 | -8.866077429034183 | 0.0
PAL | 0.7 | -4.0 | P64-LowCN-E1 | -9.059771979924673 | 0.0
PAL | 0.7 | -3.0 | U85Q | -8.01875835703281 | 0.0
PAL | 0.7 | -3.0 | U80P64-R1 | -8.415090499933871 | 0.0
PAL | 0.7 | -3.0 | P64-LowCN-E1 | -8.531129653593906 | 0.0
PAL | 0.7 | -2.0 | U85Q | -7.100870096041309 | 0.0
PAL | 0.7 | -2.0 | U80P64-R1 | -7.7127577139329775 | 43.06569343065693
PAL | 0.7 | -2.0 | P64-LowCN-E1 | -7.786122158434502 | 68.97810218978103
PAL | 0.7 | -1.0 | U85Q | -6.142199165515833 | 75.61837455830388
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
