JulienChagnon/C5VRX/legacy/c5vrx3/docs/issue-17-true40-cadence-and-interleaved-phase5.md

# Issue #17: True 40 MS/s DAC Cadence, Adjacent25 Failure Modes, and Interleaved Demodulation

## 1. Executive Summary & Problem Context

In PR #18, an initial attempt was made to solve Issue #17 ("True 40 MS/s DAC Cadence") by transitioning from the baseline 20 MS/s Phase5 core (which emitted 50 ns flat holds `[A, A]`) to an adjacent 25 ns differentiator (`adjacent25`: $s_n - s_{n-1}$).

Live hardware testing immediately revealed a severe video quality regression ("it has become MUCH worse" (translated from Dutch)):
- Extreme video static and rail-to-rail "color bursts" / clicks.
- Jagged edge artifacts ("larger jagged edges", translated from Dutch) were enlarged rather than smoothed.
- Benchmark verification demonstrated that hard error tail spikes ($\ge 16$ codes) increased from 11.28% to 14.44% (with $\ge 8$ codes reaching 22.0%), despite apparent in-sample MAE improvements.

This document details the root-cause physics of the regression, the digital firmware fixes applied, the strict physical laws governing the BitScrambler pipeline, and the mathematical roadmap for 40 MS/s WBFM demodulation.

---

## 2. Root Causes of the PR #18 Regression

Analysis revealed four compounding root causes in PR #18:

### Root Cause A: Loss of the 50 ns Boxcar Noise Notch (+6 dB Triangular Noise)
The noise power spectral density of an analog FM discriminator is triangular with respect to frequency:
$$S_N(f) \propto f^2$$

In the baseline Phase5 demodulator, the phase difference is evaluated over a 50 ns span ($x[n] - x[n-2]$):
$$H_{50}(z) = 1 - z^{-2} = (1 - z^{-1})(1 + z^{-1})$$

The factor $(1 + z^{-1})$ is a 2-sample boxcar filter placing a transmission zero (notch) at $z = -1$, exactly at $f = 20\text{ MHz}$. High-frequency phase noise near the Nyquist limit is naturally suppressed.

In `adjacent25`, differentiation is evaluated over 25 ns ($x[n] - x[n-1]$):
$$H_{25}(z) = 1 - z^{-1}$$

This removed the 20 MHz boxcar zero. Furthermore, because a 25 ns delta produces half the angular deviation of a 50 ns delta, the discriminator required a $\times 2$ gain multiplier (increasing from $\times 3.0$ to $\times 6.0$) to maintain a standard 1.0 Vpp CVBS swing. Doubling the gain doubled the triangular noise slope, increasing high-frequency noise power by **+6 dB**.

### Root Cause B: 5-Wire Cartesian Quantization Collapse ($Q[3:1], I[3:2]$)
To fit two lookups or adjacent sample state into BitScrambler's 10-bit address bus without intermediate instructions, PR #18 downsampled the 8-bit packed $Q4/I4$ byte to 5 wires:
- $Q[3:1]$: 3 bits (8 levels)
- $I[3:2]$: 2 bits (4 levels)

This 5-wire bit slicing introduces an inherent angular quantization error up to **$\pm 40.4^\circ$** on each sample. When two adjacent 25 ns samples each suffer independent $\pm 40^\circ$ errors, their difference can swing by $\pm 80^\circ$. At a gain factor of $\times 6.0$, an $80^\circ$ angular error produces a jump of $\approx 43$ DAC codes—immediately slamming the DAC into the rails (0 or 63).

### Root Cause C: In-Sample Overfitting and Catastrophic Rail Clipping
The LUT in PR #18 was trained on `vtx_real_capture_v3.bin` using median bin assignment. Because the training set contained extreme noise spikes, **822 out of 1024 LUT entries (55.4%) were pegged hard at 0 (sync tip) or 63 (peak white)**.

Whenever live RF noise pushed the wire states into untrusted or clipped bins, the DAC produced full-scale white and black spikes, corrupting the analog monitor's sync separator and flooding the screen with static.

### Root Cause D: Hardware Peripheral Mismatches
1. **Clock Mismatch in `main/realtime.c`**: In `main/realtime.c`, `CONFIG_C5VRX2_WBFM_TRUE40` was omitted from `#elif`, causing `CVBS_RATE_HZ` to fall back to `20000000u` (20 MHz) while PARLIO TX was clocked at 40 MHz.
2. **Forced Inverted Sampling Edge**: `CONFIG_C5VRX2_PARLIO_RX_NEG_EDGE=y` was forced in `sdkconfig.true40.defaults`, altering the physical RX sampling edge away from the proven Phase5 baseline.

---

## 3. Physical Laws of the BitScrambler Pipeline

The BitScrambler architecture on the ESP32-C5 operates under strict hardware constraints that cannot be bypassed:

1. **The 2-Bundle Physical Law:**
   - The BitScrambler core runs on the fixed 40 MHz AHB/bus clock (25 ns per cycle).
   - At 40 MS/s PARLIO TX cadence, each output byte consumes exactly 25 ns.
   - For every 2-byte transaction (50 ns), BitScrambler has strictly **2 clock cycles = 2 instruction bundles**.
   - Attempting 3 or more bundles (such as 5 bundles in commit `4387421` or 6 bundles in `linear80`) takes $\ge 75$ ns per 2 bytes. The PARLIO TX FIFO empties faster than BitScrambler can produce data, causing immediate TX FIFO underrun and a black screen.
2. **Single LUT Lookup per Bundle:**
   - Each bundle can issue at most one LUT address via bits 16..31 (`out >> 16`). The lookup result $L$ is available only on the subsequent bundle.
3. **Single Opcode Constraint:**
   - BitScrambler allows at most one opcode per instruction bundle.
   - The loop termination bundle must contain `jmp <label>` (`OP_IF`). Because `jmp` occupies the opcode slot, it cannot be combined with counter arithmetic (`ADDCTI` / `LDCTI`).

---

## 4. Applied Firmware Fixes (Current Working Tree)

To eliminate the static and restore 40 MS/s DAC cadence, the following fixes were applied and verified:

1. **Restored 40 MHz PARLIO Clock Rate (`main/realtime.c`)**:
   Added `CONFIG_C5VRX2_WBFM_TRUE40` to `#elif`, ensuring `CVBS_RATE_HZ` is explicitly `40000000u`.
2. **Restored Positive Sampling Edge (`sdkconfig.true40.defaults`)**:
   Removed `CONFIG_C5VRX2_PARLIO_RX_NEG_EDGE=y`, returning to clean rising-edge sampling matching the proven baseline.
3. **Analytical Circular Soft-Saturation LUT (`tools/train_true40_lut.py`, `main/true40_lut.h`)**:
   - Replaced in-sample capture training with analytical circular centroids computed across all 256 Cartesian inputs.
   - Designed a smooth hyperbolic tangent soft-saturation transfer function:
     $$\Delta\theta = (\theta_{curr} - \theta_{prev}) \pmod{2\pi}$$
     $$\text{dev} = 26.0 \times \tanh\left(\frac{30.0 \times \Delta\theta}{26.0}\right)$$
     $$\text{DAC} = \text{clamp}(4, 60, \text{round}(20 + \text{dev}))$$
   - **0.00% clipping at 0 or 63** (down from 55.4%).
   - Unique DAC levels jumped from **6 to 39 levels**.
   - Hard error spikes $\ge 32$ codes plummeted to **0.03%**.
   - 16.42 MHz DAC image suppression on NTSC burst carrier reached **-35.92 dBc** (25.1 dB improvement over Phase5 baseline).
4. **Verification**:
   - All tests in `tools/test_true40_oracle.py` pass with **0 bit-for-bit mismatches** against the C reference model.

---

## 5. Architectural Comparison of 40 MS/s Candidates

Benchmarking on 16,384 bytes of physical RF capture (`vtx_real_capture_v3.bin`) reveals the exact quantitative trade-offs across all candidate algorithms:

| Algorithm | Bundles | Cadence | Levels | Mean Jump | Jumps $\ge 8$ | Jumps $\ge 16$ | Jumps $\ge 32$ | Clip 0/63 |
|---|---|---|---|---|---|---|---|---|
| **Phase5 Hold40 (Baseline)** | 2 | 20 MS/s (held 2x) | 30 | 3.53 | 20.71% | 3.06% | 0.59% | 5.55% |
| **HW True40 Adjacent25 (PR18 Cleaned)** | 2 | 40 MS/s (25 ns) | 35 | 4.55 | 27.20% | 15.10% | 0.08% | 0.00% |
| **HW Interleaved 50ns (Phase5++)** | 2 | 40 MS/s (25 ns) | 38 | 4.09 | 24.31% | 13.11% | 0.10% | 0.00% |
| **Ideal Span50 Cadence25 (Oracle)** | - | 40 MS/s (25 ns) | 30 | 4.25 | 23.33% | 2.58% | 0.44% | 5.45% |
| **Linear40 (Midpoint Interpolation)** | 6 | 40 MS/s (25 ns) | 48 | 3.53 | 6.24% | 1.19% | 0.02% | 3.69% |

### Analysis of Candidates:
1. **Adjacent25**: Successfully achieves 40 MS/s distinct updates and 0% rail clipping, but retains ~15% jumps $\ge 16$ codes due to 5-wire Cartesian quantization on adjacent 25 ns steps.
2. **Linear40 ($[A, (A+B)/2]$)**: Achieves the highest visual quality (48 levels, 1.19% jumps $\ge 16$, 0% jumps $\ge 32$). However, because BitScrambler cannot combine counter addition with `jmp` in a 2-bundle loop, Linear40 requires 6 bundles and cannot run at 40 MHz without TX underrun.
3. **Interleaved 50ns**: Replaces adjacent 25 ns differentiation with interleaved 50 ns differentiation ($D_{even} = S_{even}[k] - S_{even}[k-1]$ and $D_{odd} = S_{odd}[k] - S_{odd}[k-1]$). This restores the $(1 - z^{-2})$ noise notch, lowers mean jump to 4.09 codes, increases levels to 38, and executes within strictly 2 bundles via alternating `write 8`.

---

## 6. Empirical Hardware Observation: Sporadic Large Tears ("huge jagged edges", translated from Dutch)

Live analog hardware testing of the soft-saturated True40 build on the ESP32-C5 confirmed:
1. **White/Black Rail Static Eliminated**: The previous full-scale 0/63 static flashes and "color bombs" are completely gone due to the soft-saturation LUT clamp [4..60] and 0.00% rail clipping.
2. **Fine Cadence Texture ("small jagged edges", translated from Dutch)**: The 40 MS/s DAC cadence produces distinct 25 ns analog updates ("small jagged edges", translated from Dutch) instead of the 50 ns flat holds of Phase5.
3. **Sporadic Large Tears ("a huge jagged edge cutting through the small ones", translated from Dutch)**:
   - Despite eliminating catastrophic rail clipping ($\ge 32$ codes down to 0.08%), sporadic large horizontal tears and spikes periodically cut through the fine 25 ns edge texture.
   - **Root Cause**: This is the direct visual manifestation of the **15.10% tail of jumps $\ge 16$ codes** (and 27.20% jumps $\ge 8$ codes) measured in the benchmark.
   - **Physical Mechanism**: In adjacent 25 ns differentiation with 5-wire Cartesian compression ($Q[3:1], I[3:2]$), discarding the lower bits ($Q_0, I_0, I_1$) causes the measured phase to jump by up to $\pm 40.4^\circ$ whenever the RF phasor crosses quadrant boundaries or approaches the origin under noise. When adjacent 25 ns samples straddle such a boundary, the evaluated frequency deviation spikes by 15–25 DAC codes. On an analog video monitor, this single-sample 25 ns impulse appears as an isolated horizontal spike ("huge jagged edge" (translated from Dutch)) protruding well beyond the edge.
4. **Elevated Background Static Compared to Phase5**:
   - Live observation confirms that the overall background static level remains noticeably higher than in previous Phase5 builds.
   - **Root Cause & Physics**:
     1. **Triangular Noise Density without Notch (+6 dB)**: An FM discriminator exhibits triangular noise power density ($S_N(f) \propto f^2$). The baseline Phase5 demodulator evaluates deltas over 50 ns ($(1 - z^{-2}) = (1 - z^{-1})(1 + z^{-1})$), placing a transmission zero at $f = 20\text{ MHz}$. Adjacent 25 ns differentiation ($1 - z^{-1}$) eliminates this zero and requires doubling the gain factor, increasing high-frequency noise power by **+6 dB**.
     2. **Continuous 40 MHz Noise Updates**: In Phase5, identical byte pairs `[A, A]` provided an implicit 50 ns zero-order hold filter. In True40, every 25 ns sample updates independently with unfiltered phase noise.
     3. **5-Wire Quantization Noise Floor**: Reducing 8-bit Q4/I4 (256 states) to 5 wires (32 states) raises the intrinsic Cartesian phase quantization noise floor by ~18 dB.
   - **Architectural Conclusion**: To achieve the low static floor of Phase5 at 40 MS/s cadence, the architecture must either use **Interleaved 50 ns differentiation** (which restores the 20 MHz boxcar notch and standard gain) or linear reconstruction from full 8-bit Phase5 lookups.

---

## 7. The Golden Quality Baseline: Phase5 Quality Mode

Reflashing the baseline `Phase5 Quality` firmware (`build-live/c5vrx2_realtime_iq.bin`) immediately produced an outstanding, highly stable video image on live hardware:
> *"wow this is really fantastic... small jagged edges, almost no static."* (translated from Dutch)

### Why Phase5 Delivers Superior Quality:
1. **Full 8-Bit Cartesian Precision ($Q4/I4 \to \text{atan2}$)**:
   - Phase5 feeds the complete 8-bit packed $Q4/I4$ byte (all 256 states) into the first LUT stage to extract uniform 5-bit phase.
   - Zero bits are discarded before the demodulator. The phase quantization noise floor remains at the theoretical minimum (~0.5 LSB angular precision).
2. **Inherent 20 MHz Boxcar Noise Notch ($(1 - z^{-2})$)**:
   - Differentiating over 50 ns ($x[n] - x[n-2]$) places a transmission zero directly at $f = 20\text{ MHz}$, eliminating the high-frequency triangular noise peak without requiring an external low-pass filter.
3. **Controlled 50 ns Zero-Order Hold**:
   - The DAC operates at 40 MHz PARLIO clock, emitting identical byte pairs `[A, A]`.
   - The resulting 50 ns analog steps produce clean, uniform, and stable horizontal edge pixels ("small jagged edges", translated from Dutch) with zero sporadic phase tears ($\ge 16$ code jumps are only **3.06%**, vs 15.10% in adjacent25).
4. **Physical Clock Alignment**:
   - `CVBS_RATE_HZ = 40000000u` in `main/realtime.c`.
   - Clean rising-edge PARLIO RX clock sampling (`CONFIG_C5VRX2_PARLIO_RX_NEG_EDGE=n`).

### Definitive Quality Gate for Issue #17:
Phase5 Quality Mode serves as the uncompromised golden baseline for video fidelity. Any future 40 MS/s architecture (such as 2-bundle Interleaved 50 ns) must match or exceed the low static floor and tight error distribution ($\le 3\%$ jumps $\ge 16$) of Phase5 before being considered production-ready.

---

## 8. Verification and Flashing Guide

To build and flash the verified firmware configurations:

1. **Build Golden Phase5 Firmware (`build-live`)**:
   ```bash
   idf.py -B build-live -DSDKCONFIG_DEFAULTS="sdkconfig.defaults;sdkconfig.flash40.defaults" build
   ```
2. **Build True40 Firmware (`build-true40`)**:
   ```bash
   idf.py -B build-true40 -DSDKCONFIG_DEFAULTS="sdkconfig.defaults;sdkconfig.true40.defaults" build
   ```
3. **Flash to ESP32-C5**:
   - Hold `BOOT` button on the XIAO ESP32-C5, tap `RESET`, and release `BOOT` to enter the ROM bootloader.
   - Run:
     ```bash
     python -m esptool --chip esp32c5 -p COM10 -b 460800 write_flash 0x2000 build-live/bootloader/bootloader.bin 0x8000 build-live/partition_table/partition-table.bin 0x10000 build-live/c5vrx2_realtime_iq.bin
     ```
4. **Verify Host Oracles**:
   ```bash
   python tools/test_true40_oracle.py
   ```
