JulienChagnon/C5VRX/hardware/C5VRX_JACK_DIY_V3/exports/C5VRX_JACK_DIY_V3-schematic.pdf

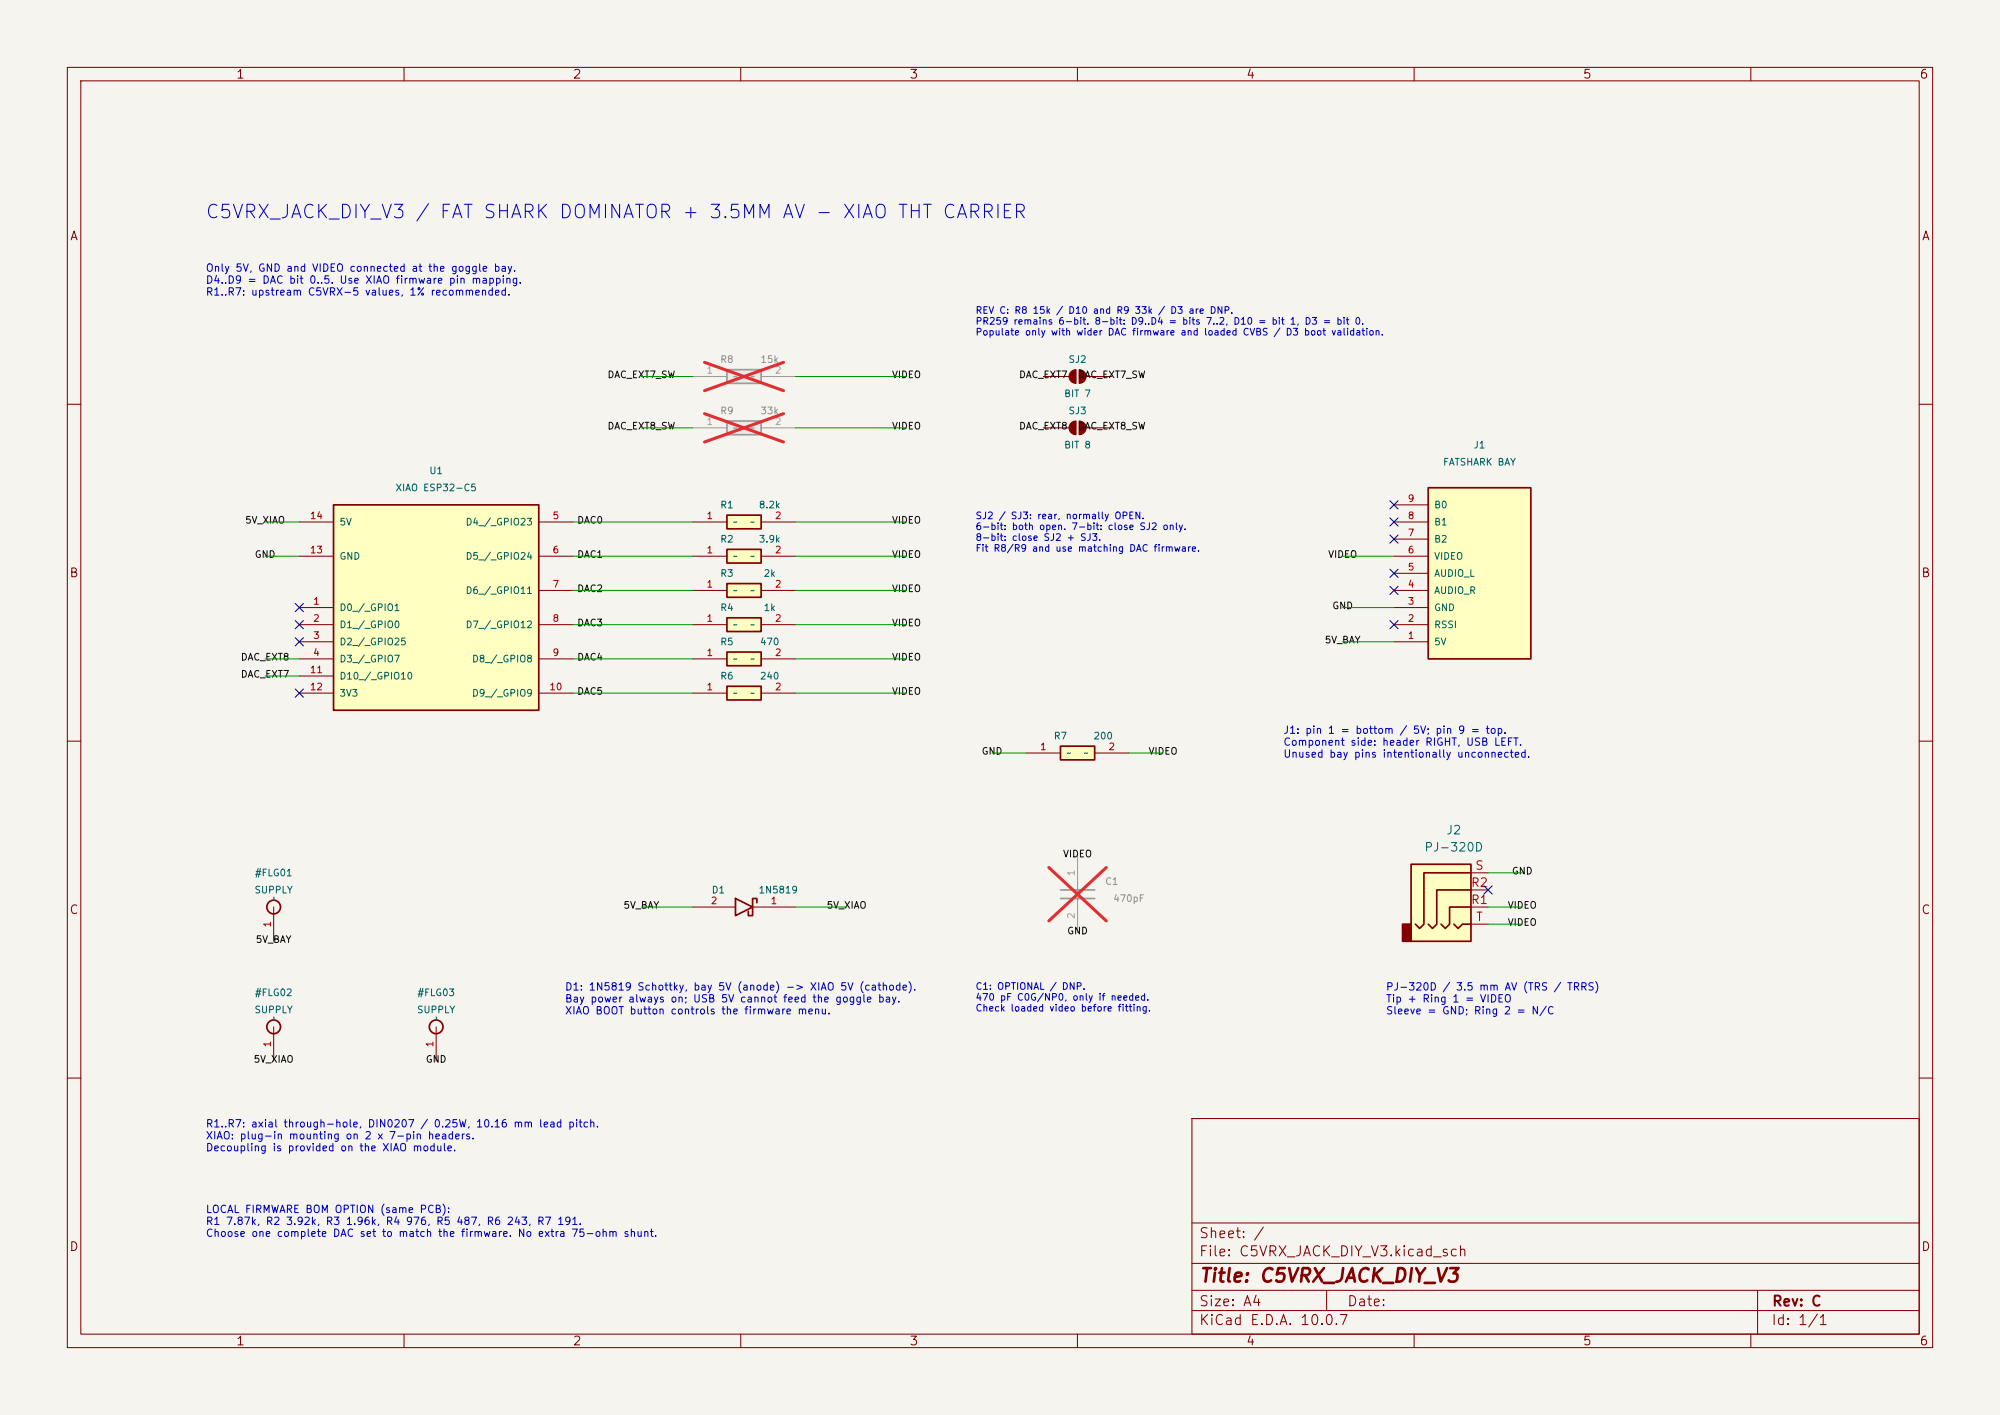
[picture p20: page 1]

REV C: R8 15k / D10 and R9 33k / D3 are DNP. PR259 remains 6-bit. 8-bit: D9..D4 = bits 7..2, D10 = bit 1, D3 = bit 0. Populate only with wider DAC firmware and loaded CVBS / D3 boot validation. SJ2 / SJ3: rear, normally OPEN. 6-bit: both open. 7-bit: close SJ2 only. 8-bit: close SJ2 + SJ3. Fit R8/R9 and use matching DAC firmware. C5VRX_JACK_DIY_V3 / FAT SHARK DOMINATOR + 3.5MM AV - XIAO THT CARRIER

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

J1: pin 1 = bottom / 5V; pin 9 = top.
Component side: header RIGHT, USB LEFT. Unused bay pins intentionally unconnected. PJ-320D / 3.5 mm AV (TRS / TRRS)

R1..R7: axial through-hole, DIN0207 / 0.25W, 10.16 mm lead pitch. XIAO: plug-in mounting on 2 x 7-pin headers. Decoupling is provided on the XIAO module. LOCAL FIRMWARE BOM OPTION (same PCB): R1 7.87k, R2 3.92k, R3 1.96k, R4 976, R5 487, R6 243, R7 191. Choose one complete DAC set to match the firmware. No extra 75-ohm shunt. D1: 1N5819 Schottky, bay 5V (anode) -> XIAO 5V (cathode).

Size: A4 | Rev: C
KiCad E.D.A. 10.0.7 | Id: 1/1
