JulienChagnon/C5VRX/hardware/C5VRX_JACK_DIY_V3/exports/C5VRX_JACK_DIY_V3-fit-check-1to1.pdf

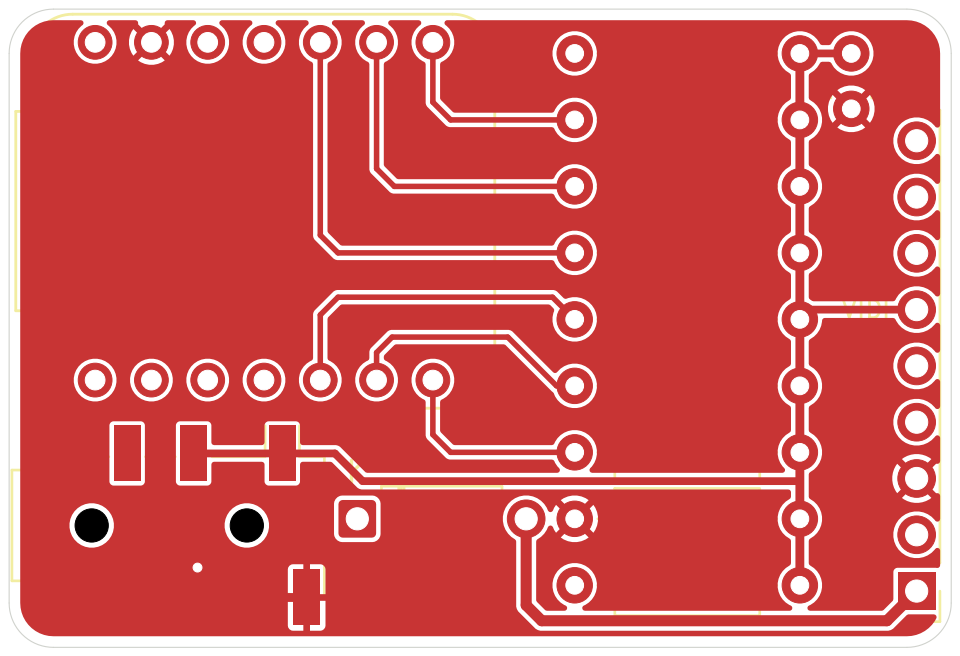
[picture p21: page 1]
