JulienChagnon/C5VRX/hardware/C5VRX_JACK_DIY_V2/exports/C5VRX_JACK_DIY_V2-fit-check-1to1.pdf

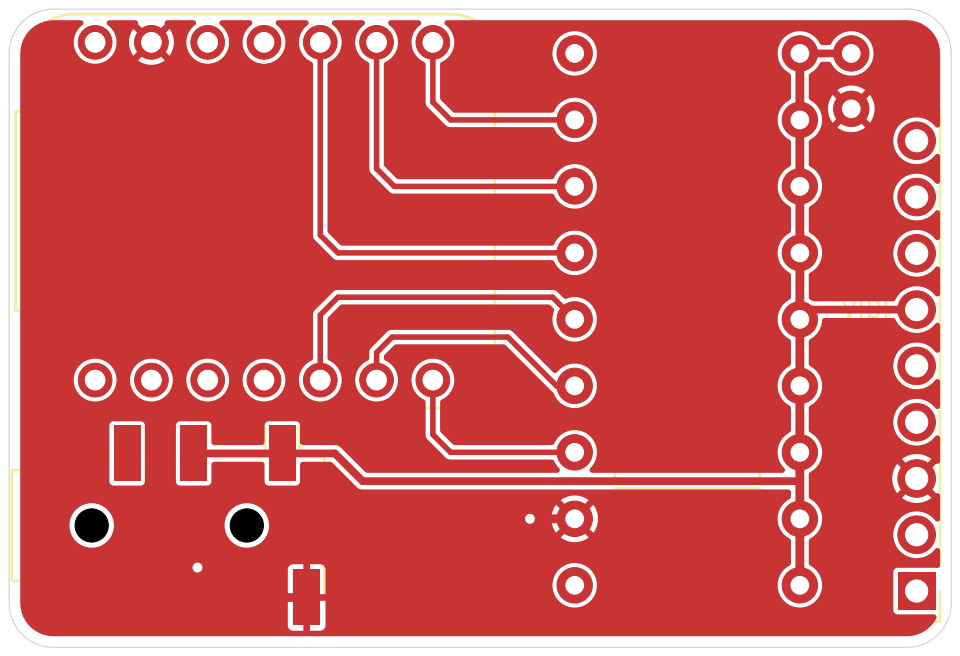
[picture p22: page 1]
