JulienChagnon/C5VRX/hardware/C5VRX_JACK_DIY/exports/C5VRX_JACK_DIY-fit-check-1to1.pdf

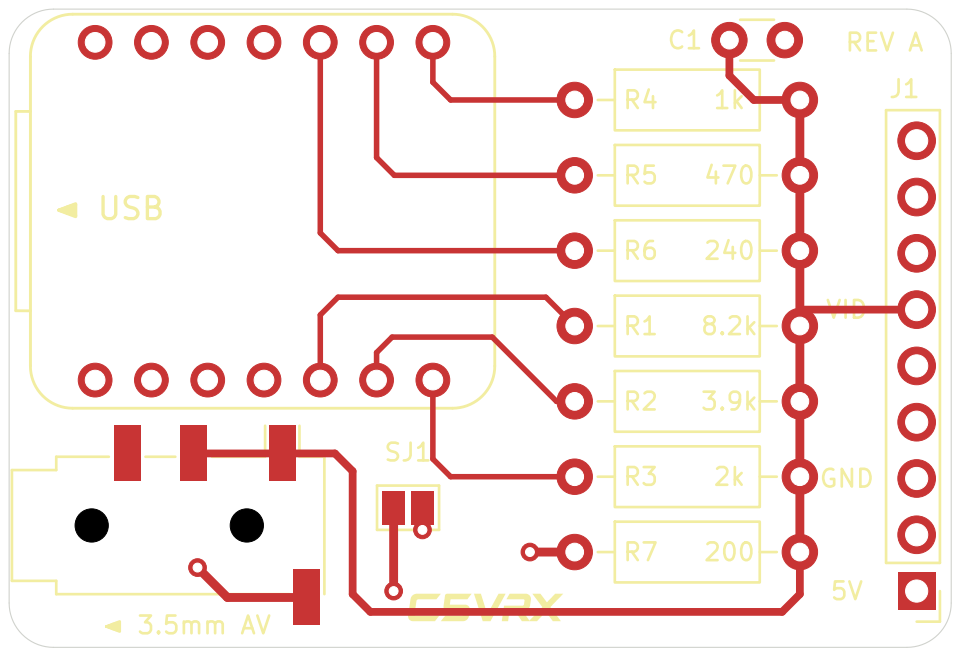
[picture p23: page 1]
