JulienChagnon/C5VRX/hardware/C5VRX_JACK_DIY_V3/C5VRX_JACK_DIY_V3.kicad_pcb

## KiCad design hardware/C5VRX_JACK_DIY_V3/C5VRX_JACK_DIY_V3.kicad_pcb (2026-10-25)

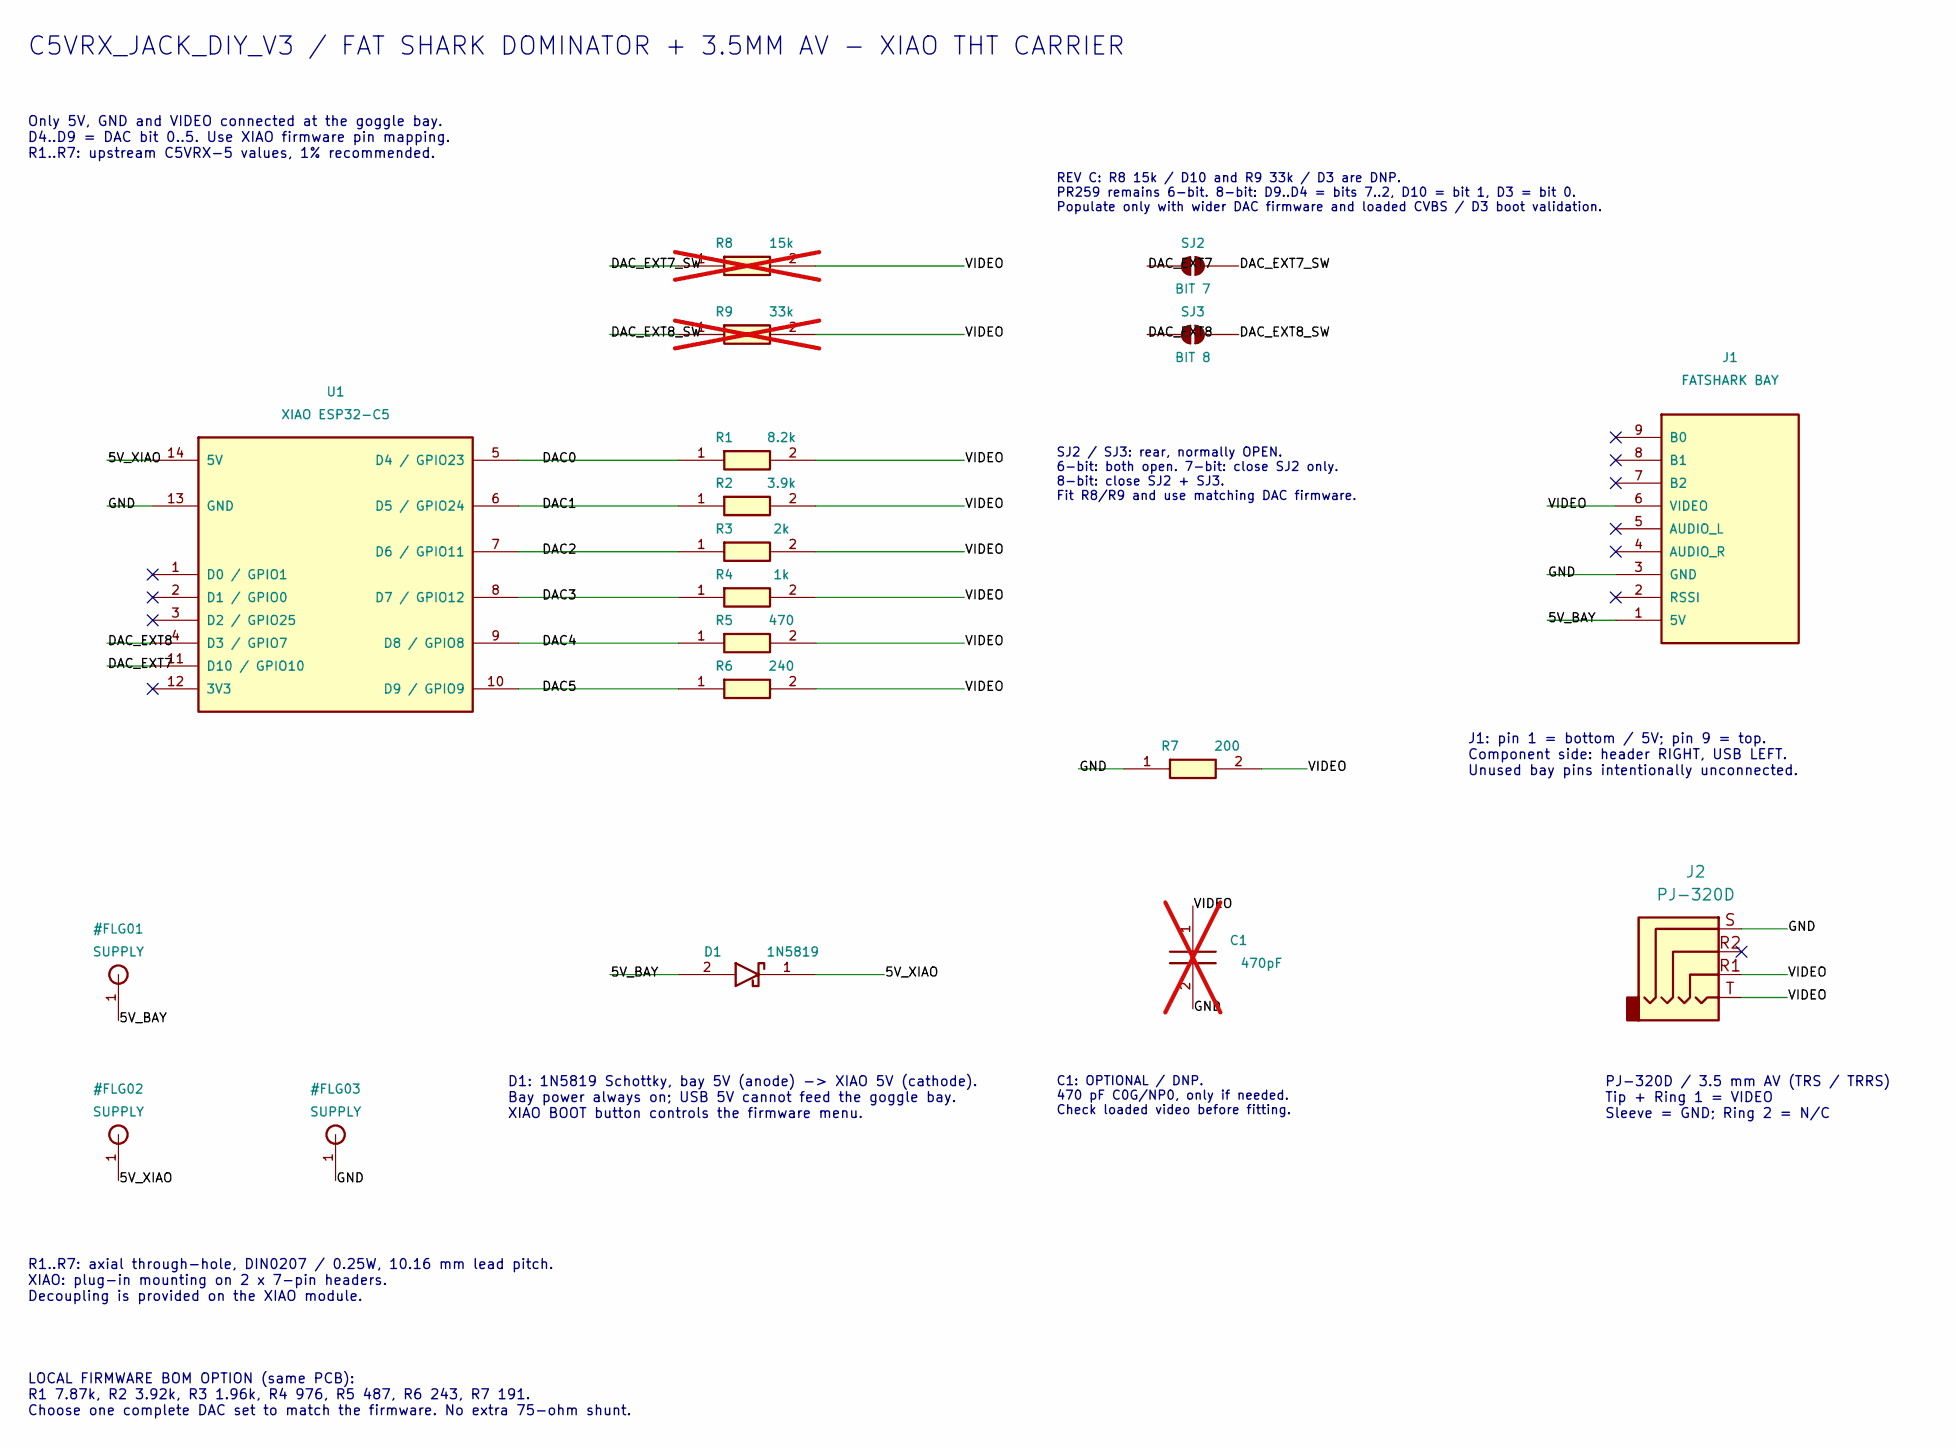
[picture p24: schematic C5VRX_JACK_DIY_V3.kicad_sch]

Parts:
C1: 470pF; C_Disc_D3.0mm_W1.6mm_P2.50mm; not fitted
D1: 1N5819; D_DO-41_P7.62mm_Horizontal_Compact
J1: FATSHARK BAY; FatShark_Header_1x09
J2: PJ-320D; Jack_3.5mm_PJ320D_Horizontal
R1: 8.2k; R_Axial_DIN0207_L6.3mm_D2.5mm_P10.16mm_Horizontal
R2: 3.9k; R_Axial_DIN0207_L6.3mm_D2.5mm_P10.16mm_Horizontal
R3: 2k; R_Axial_DIN0207_L6.3mm_D2.5mm_P10.16mm_Horizontal
R4: 1k; R_Axial_DIN0207_L6.3mm_D2.5mm_P10.16mm_Horizontal
R5: 470; R_Axial_DIN0207_L6.3mm_D2.5mm_P10.16mm_Horizontal
R6: 240; R_Axial_DIN0207_L6.3mm_D2.5mm_P10.16mm_Horizontal
R7: 200; R_Axial_DIN0207_L6.3mm_D2.5mm_P10.16mm_Horizontal
R8: 15k; R_Axial_DIN0207_L6.3mm_D2.5mm_P10.16mm_Horizontal; not fitted
R9: 33k; R_Axial_DIN0207_L6.3mm_D2.5mm_P10.16mm_Horizontal; not fitted
SJ2: BIT 7; SolderJumper-2_P1.3mm_Open_Pad1.0x1.5mm
SJ3: BIT 8; SolderJumper-2_P1.3mm_Open_Pad1.0x1.5mm
U1: XIAO ESP32-C5; XIAO-ESP32-C5-DIP

Connections:
/5V_BAY: D1.2 (A), J1.1 (5V)
/5V_XIAO: D1.1 (K), U1.14 (5V)
/DAC0: R1.1, U1.5 (D4 / GPIO23)
/DAC1: R2.1, U1.6 (D5 / GPIO24)
/DAC2: R3.1, U1.7 (D6 / GPIO11)
/DAC3: R4.1, U1.8 (D7 / GPIO12)
/DAC4: R5.1, U1.9 (D8 / GPIO8)
/DAC5: R6.1, U1.10 (D9 / GPIO9)
/DAC_EXT7: SJ2.1 (A), U1.11 (D10 / GPIO10)
/DAC_EXT7_SW: R8.1, SJ2.2 (B)
/DAC_EXT8: SJ3.1 (A), U1.4 (D3 / GPIO7)
/DAC_EXT8_SW: R9.1, SJ3.2 (B)
/GND: C1.2, J1.3 (GND), J2.S, R7.1, U1.13 (GND)
/VIDEO: C1.1, J1.6 (VIDEO), J2.R1, J2.T, R1.2, R2.2, R3.2, R4.2, R5.2, R6.2, R7.2, R8.2, R9.2

Notes on the sheet:
C5VRX_JACK_DIY_V3 / FAT SHARK DOMINATOR + 3.5MM AV - XIAO THT CARRIER
Only 5V, GND and VIDEO connected at the goggle bay. D4..D9 = DAC bit 0..5. Use XIAO firmware pin mapping. R1..R7: upstream C5VRX-5 values, 1% recommended.
J1: pin 1 = bottom / 5V; pin 9 = top. Component side: header RIGHT, USB LEFT. Unused bay pins intentionally unconnected.
D1: 1N5819 Schottky, bay 5V (anode) -> XIAO 5V (cathode). Bay power always on; USB 5V cannot feed the goggle bay. XIAO BOOT button controls the firmware menu.
R1..R7: axial through-hole, DIN0207 / 0.25W, 10.16 mm lead pitch. XIAO: plug-in mounting on 2 x 7-pin headers. Decoupling is provided on the XIAO module.
LOCAL FIRMWARE BOM OPTION (same PCB): R1 7.87k, R2 3.92k, R3 1.96k, R4 976, R5 487, R6 243, R7 191. Choose one complete DAC set to match the firmware. No extra 75-ohm shunt.
C1: OPTIONAL / DNP. 470 pF C0G/NP0, only if needed. Check loaded video before fitting.
PJ-320D / 3.5 mm AV (TRS / TRRS) Tip + Ring 1 = VIDEO Sleeve = GND; Ring 2 = N/C
REV C: R8 15k / D10 and R9 33k / D3 are DNP. PR259 remains 6-bit. 8-bit: D9..D4 = bits 7..2, D10 = bit 1, D3 = bit 0. Populate only with wider DAC firmware and loaded CVBS / D3 boot validation.
SJ2 / SJ3: rear, normally OPEN. 6-bit: both open. 7-bit: close SJ2 only. 8-bit: close SJ2 + SJ3. Fit R8/R9 and use matching DAC firmware.

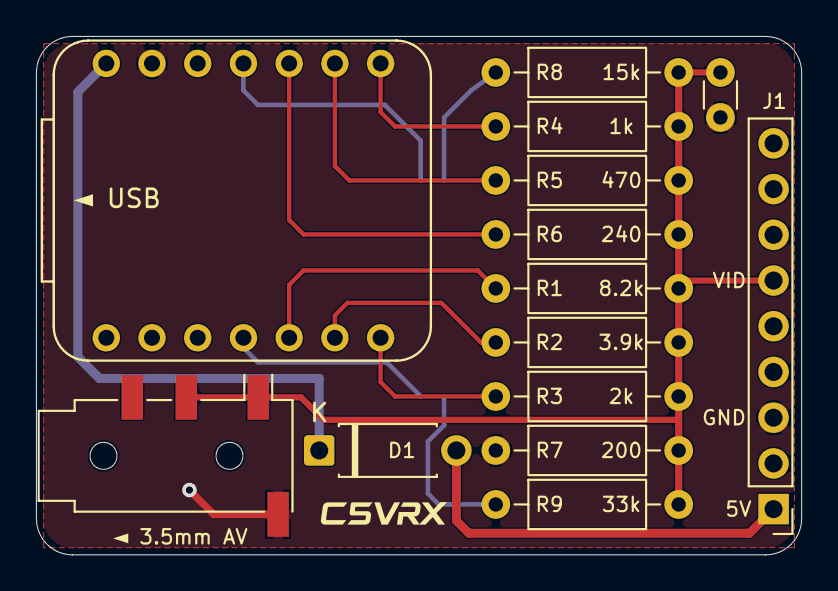
[picture p25: board C5VRX_JACK_DIY_V3.kicad_pcb from above]

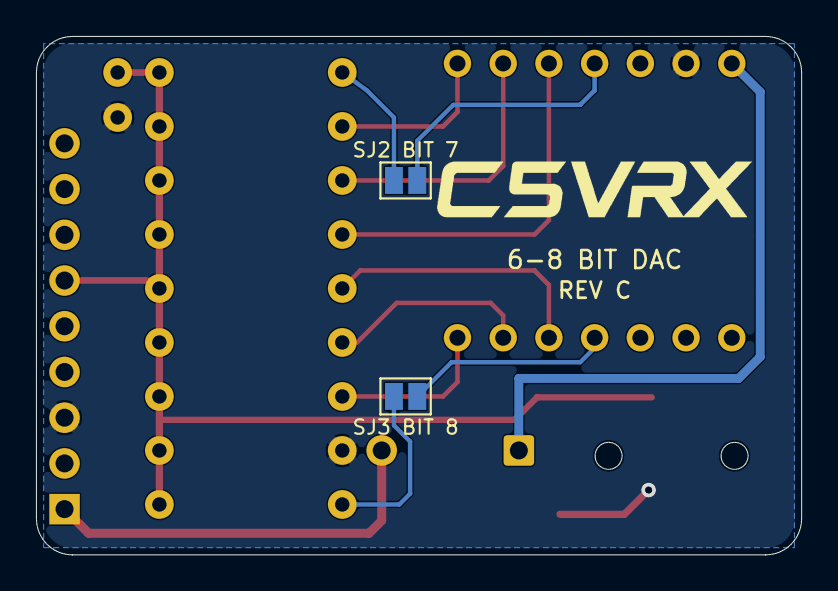
[picture p26: board C5VRX_JACK_DIY_V3.kicad_pcb from below]

Board: 2 copper layers, 42.5 x 28.8 mm, 18 parts (2 on the bottom side), 14 nets.

Other parts of the board:
LOGO1: C5VRX logo; C5VRX_Logo_Back
LOGO2: C5VRX Front Logo; C5VRX_Logo_Front_Small
