JulienChagnon/C5VRX/main/dsp.h

/* C5VRX-5 by Twotoz and the C5VRX contributors: pure helpers over raw
 * Q4/I4 bytes (I high nibble, Q low nibble, signed), from C5VRX-4
 * firmware/include/predemod.h. Observers only, never the 40 MS/s path. */
#pragma once
#include <stdbool.h>
#include <stddef.h>
#include <stdint.h>
#include <math.h>
#ifndef M_PI
#define M_PI 3.14159265358979323846
#endif

static inline int dsp_i(uint8_t b) { return (int8_t)(b & 0xf0u) >> 4; }
static inline int dsp_q(uint8_t b) { return (int8_t)(uint8_t)(b << 4) >> 4; }

/* Fourth-difference probe (zerowidth/C5VRX PR #3): a read that lands on a
 * MODEM_DIAG transition mixes old and new bits and spreads error evenly,
 * while the receive filter leaves little above ~10 MHz. */
static inline void dsp_hf4_sums(const uint8_t *s, size_t n, uint64_t *d4)
{
    static const int w[5] = {1, -4, 6, -4, 1};
    for (size_t k = 2; k + 2 < n; ++k) {
        int di = 0, dq = 0;
        for (int j = -2; j <= 2; ++j) {
            di += w[j + 2] * (2 * dsp_i(s[k + j]) + 1);
            dq += w[j + 2] * (2 * dsp_q(s[k + j]) + 1);
        }
        *d4 += (uint64_t)(di * di + dq * dq);
    }
}

/* Second-difference energy over the same samples as dsp_hf4_sums: the
 * reference for the level-independent HF4/HF2 whiteness (sphase_logic.h). */
static inline void dsp_hf2_sums(const uint8_t *s, size_t n, uint64_t *d2)
{
    for (size_t k = 2; k + 2 < n; ++k) {
        int di = (2 * dsp_i(s[k - 1]) + 1) - 2 * (2 * dsp_i(s[k]) + 1) + (2 * dsp_i(s[k + 1]) + 1);
        int dq = (2 * dsp_q(s[k - 1]) + 1) - 2 * (2 * dsp_q(s[k]) + 1) + (2 * dsp_q(s[k + 1]) + 1);
        *d2 += (uint64_t)(di * di + dq * dq);
    }
}

/* Excess fourth-difference energy, milli-cell^2 per sample, rounding share
 * removed. Board scans 2026-10-08, fixed ultrafine: clean positions
 * -70..+42, mid-change positions 391..3742. */
static inline int dsp_hf4_excess_milli(uint64_t d4, uint64_t count)
{
    if (!count) return 0;
    double excess = (double)d4 / (double)count / 70.0 / 4.0 - 2.0 / 12.0;
    return (int)(1000.0 * excess);
}
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
