JulienChagnon/C5VRX/(commit log)

2026-10-12 fix: zero-init kp_ladder_t in test_kp_ladder
    [test_kp_ladder.c]
2026-10-12 fix: field_diag_compare test runs on Windows
    [test_field_diag_compare.py]
2026-10-20 fix(c5vrx5): kp_restarts_skipped counts skipped restarts, not ticks
    [control.c]
2026-10-20 fix(c5vrx5): no DC deadlock: row bans expire, a proven polarity is not flipped by folded IQ
    Board 2026-10-20 (new antenna, a stronger carrier): G83 sat at 4 cells of
    DC on both axes, every probe clipped, and nothing recovered:
    - the DC servo's I polarity had flipped to -537: with the carrier folding
    the IQ, the sign share says nothing about the DC, and the fold check
    turned a correct polarity;
    - the hold guard then banned the row for good (railing IQ under held
    codes), the servo skipped banned rows, and KEEL read the one-sided
    clipping as DC, not as a strong carrier: a deadlock.
    - A ban lasts 2 s, doubling per repeat up to 32 s, then the row is held
    again (T DCO_BAN unbans).
    - Pol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
    [calibration.c, dc_servo.h, test_dc_servo.c]
2026-10-20 fix(c5vrx5): the gain table steps 1.0 dB a row below the measured rows; antenna-to-pin budget closes
    Pair sweep on a 100 mW carrier at 2 m (board, AXII 2): ~1.0 dB a row over
    G19-G31 (11.6 dB for 12 rows), as on noise at G72-G83 and the earlier
    G29-G39 sweep. The RF-stage/BB/fine model has steps of -3.3 and +2.7 dB
    there and is 4.2 dB short at G24, so the dBm meter read a strong carrier
    4 dB low. Below the noise-measured rows the table now steps 1.0 dB a row
    (dBm meter, KEEL-1 home rows).
    Corrected, the carrier read about -34.5 dBm against ~-34 dBm from free
    space (100 mW, whoop to AXII 2, 2 m): no loss between antenna and chip
    (the XIAO ESP32-C5 routes U.FL straight to LNA_IN, no antenna s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
    [gain.c, test_gain_measured.c]
2026-10-20 fix(c5vrx5): load target LUT once per verified transport restart
    [kp_lut_io.h, test_kp_lut_io.c, transport.c]
2026-10-20 fix(c5vrx5): recover gain from recorded origin-cloud outliers
    [gain.c, test_gain_v7.c]
2026-10-21 fix(c5vrx5): keep uncalibrated C/N out of RF controls
    [cn_auto.h, cn_estimate.h, control.c, kp_ladder.h, receiver.c, test_cn_auto.c]
2026-10-21 fix(c5vrx5): reset C/N across receiver contexts
    [control.c, test_kp_ladder.c]
2026-10-21 test(c5vrx5): keep context fixture inside LP hold
    [test_kp_ladder.c]
2026-10-21 fix(c5vrx5): hold kp when control C/N is unknown
    [kp_ladder.h, test_kp_ladder.c]
2026-10-22 fix(c5vrx5): count flight log snapshots dropped for memory or a busy receiver
    A snapshot request is consumed when the logger picks it up, and snapshot()
    returned without a trace when the heap had no block for the IQ copy plus
    8 KiB left for the menu, or when the receiver was busy or settling. Y now
    reports both as snapshots_no_memory and snapshots_refused.
    Board, XIAO ESP32-C5, 2026-10-21: VTX switched on and off six times close
    to the receiver, heap_largest=14336 the whole session (16382 needed):
    snapshots=0, snapshots_no_memory=16, snapshots_refused=0.
    [flightlog.c]
2026-10-22 C5VRX-5: log verified output sync telemetry (#241)
    * feat: log verified output sync telemetry
    * fix: treat busy PHY output observations as unknown
    [flight_log.py, flightlog.c, flightlog_format.h, receiver.h, test_flight_log_tool.py, test_flightlog.c, transport.c]
2026-10-22 fix(c5vrx5): a dropout snapshot request replaces a pending lower one
    flightlog_snapshot_request() kept whichever request arrived first while it
    waited for the 10 s snapshot gap. A dropout or edge request arriving behind
    a pending periodic or picture-drop request was dropped. The IQ is copied
    when the snapshot is taken, so the data was the same, but it was stored
    under the lower trigger: decoded as the wrong event, evicted sooner, and
    skipped outright once the ring was full of more important snapshots.
    flog_snap_request_merge() now replaces the pending request when the new
    one has a higher flog_snap_priority(); at equal priority the first stays.
    Host test: test/test_flightlog.c (32/32). On t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
    [flightlog.c, flightlog_format.h, test_flightlog.c]
2026-10-22 feat(c5vrx5): check the gain table against the PHY's AGC memory at boot
    The 5 GHz RX gain table is rebuilt from the vendor generator
    (arc_phy.c) and was never compared with the table the PHY installs. The
    modem maps its AGC memory into the APB window at 0x600ae000 when
    MODEM_LPCON_APB_MEM_SEL selects it, as vendor apb_get_mem() in
    librftest.a does. One entry is four words: RF code = w2 << 5 | w1 >> 27,
    fine = (w1 >> 24) & 7, BB = (w1 >> 17) & 0x7f.
    At every table capture the rows are read through that window and checked
    against the reconstruction; T prints GAIN_TABLE_HW and a mismatch is
    reported at boot. Host test test/test_agc_table.c uses the words read on
    the board.
    Board, XIAO ESP32-C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
2026-10-22 fix(c5vrx5): lock the snapshot request merge and the logger's take
    volatile made the byte visible but neither the read/merge/write in
    flightlog_snapshot_request() nor the logger's read/clear was atomic. A task
    preempted between reading and writing could overwrite a newer DROPOUT with
    its OVERLOAD, and the logger could clear a request stored after its read.
    Both now run under one spinlock (s_snap_lock); snapshot() is called after
    leaving it, since it erases and writes flash. All callers are tasks.
    [flightlog.c]
2026-10-23 fix(c5vrx5): apply verified digital RX filter mode 0
    [calibration.c, gain.h, phy.c, phy.h, receiver.c, rf.c, rf.h, test_dfilt_runtime.py]
2026-10-23 fix(c5vrx5): invalidate noise-derived gain table for mode 0
    [receiver.c, test_dfilt_runtime.py]
2026-10-23 fix(console): gate P64 selection during calibration and clarify status
    [control.c]
2026-10-23 fix(p64): guard profile restarts and report the active decoder at boot
    [main.c, transport.c]
2026-10-23 fix(receiver): restore U85Q boot default after P64 board regression
    [console.c, control.c, transport.c]
2026-10-23 fix(p64): recover committed phase advance and escape porch sync latch
    [console.c, p5t_eval.py, p64_model.py, p64_tables.h, p64_validation.py, test_p64.py, transport.c]
2026-10-23 research(demod): record bounded low-CN search and rejected candidates
    [validation.csv]
2026-10-23 Add compact build components and tidy the README (#252)
    * Add compact component cards and simplify README
    * Include the XIAO ESP32-C5 in the component table
    * Use PNG for the C5 product photo
    * Use a transparent C5 product photo
    * Update resistor kit product link
2026-10-23 test(demod): remove retired LP assertions and enforce CI compile failures
    [test_cn_auto.c]
2026-10-23 perf(c5vrx5): send the flight log dump through the USB driver
    Console W fed the 64-byte USB FIFO a byte at a time and dropped bytes
    whenever the host was slow for 50 ms. With the receiver live a full log
    took 39 s at 66 KiB/s, lost 10 of 4945 lines (the readers then repeat the
    whole dump) and dropped 24 records, because the logger cannot flush while
    W holds the flash.
    W now installs the USB driver with a 4 KiB ring for the length of the
    dump, writes whole lines into it and removes it afterwards. Everyday
    output keeps the non-blocking path, so a board without a host still never
    waits on USB. A host that stops reading ends the dump after 1 s, the
    download key still works mid-dump, and without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
2026-10-23 feat(web): show how long the flight log read took and flag a slow USB path
    FLOG_END now carries the pass's time (ms=) and USB path (usb=driver|fifo).
    The reader sums the time over passes and the status line ends with
    "Read in N s". When a pass had no heap for the USB driver and used the
    slow byte path, the status says so, so a 40-second read is explained
    instead of looking like a hang. Firmware without these fields shows
    nothing new.
2026-10-23 web: align receiver menu, add safety notice and match Amazon purchase buttons
2026-10-23 fix(c5vrx5): report the heap in FLOG_END; explain the slow path by the menu
    A browser read fell back to the byte path. Board sweep 2026-10-23: the
    largest free block is 9728 bytes from 1 s after boot to live, but 1664
    with the on-screen menu open, too little for the 4 KiB ring. The byte
    path takes 10-13 s there (the menu pauses the live work), not the 40 s
    it took live, so the web note now names the menu instead of quoting the
    live numbers. FLOG_END adds heap=<largest free block> so the next slow
    read shows its cause.
    [flightlog.c]
2026-10-23 web: explain the six-resistor AV output in plain language
2026-10-23 web: preview the upcoming DIY kit with supplied board renders
2026-10-23 web: align flight log content and responsive action buttons
2026-10-24 hw: add C5VRX_JACK_DIY Fat Shark carrier board and production files (#255)
    * hw: add C5VRX_JACK_DIY Fat Shark carrier board and production files
    - 42.51 x 28.80 mm carrier board fitting standard Fat Shark module bays
    - Socketed Seeed Studio XIAO ESP32-C5 (2x7-pin 2.54mm header) facing USB-C left
    - 4-pole TRRS 3.5mm AV jack (PJ-320D) facing left under the XIAO
    - 6-bit R-2R ladder (R1-R7) and filter C1 using axial 1/4W through-hole footprints
    - 9-pin right-angle male header for Fat Shark goggle bays
    - Solder jumper SJ1 for 5V bay power
    - Includes KiCad schematic/pcb, footprint library, 3D step model, BOM, Gerbers, and renders
    * docs: feature C5VRX_JACK_DIY carrier PCB with photos and specs i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
    [BOM.csv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]
2026-10-25 Remove the sync flywheel completely
    Operator decision 2026-10-25: on the board the flywheel gave extreme
    desyncs and poor range. Remove it from the firmware, web console, CI and
    tests instead of leaving it switchable.
    Firmware: drop the native comparator observer, edge clock, live gate and
    DAC-OE sync output, the comparator flag LUT format and GPIO23 clamp, the
    coasting restart lease, the 2-ms control tick (back to the plain 50-ms
    tick), the menu FLYWHEEL item and its PHY-release/retry handshake,
    console U and the SYNC_LIVE/SYNC_FLYWHEEL* reports. A saved NVS
    "flywheel" key is ignored. Flight-log V1 wire slots are kept so old logs
    decode; current firmware writes them empty.
    Web: remove the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
2026-10-25 feat(menu): black-and-white settings list, new fonts and boot logo
    The menu raster is unchanged (384 x 56 UI rows, same SRAM, same DMA
    chain); only the picture drawn into it is new.
    - One settings list instead of nine pages: every row visible at once,
    label left and current value right (band, channel, standard with the
    detected one, output level, gain mode), the selected row on a white
    pill. Hold changes the selected row, as before.
    - A grey live card beside the list keeps frequency, channel/band, signal
    and level in view, shows scan progress and the DAC TEST ramp/bars, and
    names the hold action in one word. Range warnings (DC CAL!, GAIN!)
    replace the link state, as before.
    - Fo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
    [main.c, menu.c, menu_font.py, menu_logo.py, menu_preview.py, menu_ui.c]
2026-10-25 feat(menu): boot logo waits for the first Direct Gain hold
    The splash no longer just sleeps. It opens before the receiver tasks
    start, the gain observer runs under it (RX stays live under the menu
    raster; receiver_active() allows the splash), and the bar follows the
    real steps: tasks started, then the first Direct Gain hold (also
    reached without a carrier, at the table maximum). The logo stays at
    least 3 s and at most 4 s; live video then starts on a held gain.
    The control task treats the splash like a status screen (no button,
    no menu idle), and the startup phase already waits for the menu raster
    to be free, so neither can act during the logo. Boot logs
    "SPLASH gain G<n> held after <ms> ms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
    [control.c, main.c, menu.c, receiver.c, receiver.h]
2026-10-25 fix(menu): boot bar fills evenly over 3 s
    The bar now follows time alone, from the start of the splash to 3 s;
    the first Direct Gain hold only decides whether the logo stays up to
    4 s. Before, a hold at 50 ms (no VTX) filled the bar at once.
    Board (XIAO C5): flashed, 30 s without a USB drop, uptime and the
    startup phase run normally.
    [main.c]
2026-10-25 Add REV B DIY jack carrier with reserved 7/8-bit DAC jumpers
    [BOM.csv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]
2026-10-25 Update REV B README and replace ground bridge with copper pour
    [C5VRX_JACK_DIY_V2-B_Cu.gbl, C5VRX_JACK_DIY_V2-B_Mask.gbs, C5VRX_JACK_DIY_V2-B_Paste.gbp, C5VRX_JACK_DIY_V2-B_Silkscreen.gbo, C5VRX_JACK_DIY_V2-Edge_Cuts.gm1, C5VRX_JACK_DIY_V2-F_Cu.gtl, C5VRX_JACK_DIY_V2-F_Mask.gts, C5VRX_JACK_DIY_V2-F_Paste.gtp]
2026-10-25 research(agc): LEVEL input-level AGC and RSSI baseline, comparison harness
    A first-principles look at the gain loop. The receiver noise is set
    before the baseband gain, so a row scales carrier and noise alike and the
    carrier level referred to the input is row-independent. LEVEL keeps a
    ~20 ms histogram of that level and picks the home row whose predicted
    sync/picture quality over it is best (C/N, quantisation, the detector's
    small-signal loss, ultrafine folding), with hysteresis and an immediate
    decision on a fold. RSSI is a classic mean-power AGC (target radius ~3.5
    cells, +-3 dB dead band, 6 dB drop on a fold) as a simple baseline.
    Both are integer per window; the quality table is built on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
    [agc.c, agc.h, test_agc_compare.c]
2026-10-25 REV B: latest silkscreen layout, regenerated fabrication files and new renders
    - Front: drop REV B marking (kept on back), realign J1 labels; nudge GND
    0.3 mm so it clears the header outline (DRC silk_overlap)
    - Regenerate Gerbers, drills, STEP/GLB, PDFs, SVGs and DRC/ERC reports
    - New 3200x2200 raytraced render gallery with an extra low-angle view
    - README: render gallery, label notes, repo-relative report links
    [C5VRX_JACK_DIY_V2-B_Cu.gbl, C5VRX_JACK_DIY_V2-B_Mask.gbs, C5VRX_JACK_DIY_V2-B_Paste.gbp, C5VRX_JACK_DIY_V2-B_Silkscreen.gbo, C5VRX_JACK_DIY_V2-Edge_Cuts.gm1, C5VRX_JACK_DIY_V2-F_Cu.gtl, C5VRX_JACK_DIY_V2-F_Mask.gts, C5VRX_JACK_DIY_V2-F_Paste.gtp]
2026-10-25 ci: sweep closed PR channels out of the web flasher
    The per-PR cleanup ran on the build's pull_request close event, which
    GitHub does not deliver for PRs with merge conflicts or outside the path
    filter. Channels of closed PRs (#196-198, #242-245) stayed as prereleases
    and in the Pages mirror.
    pr-channel-cleanup.yml deletes every c5vrx5-pr-N release whose PR is not
    open (on pull_request_target close, hourly and manually) and redeploys the
    flasher when it removed one. Publish skips a PR that closed mid-build.
2026-10-25 feat(agc): LEVEL and RSSI selectable in the GAIN row, self-calibrating LEVEL
    - GAIN (menu and console G) cycles AUTO (KEEL-1, default) -> LEVEL ->
    RSSI -> MAX -> fixed; not stored, every boot starts AUTO. LEVEL and RSSI
    count as automatic: no GAIN!/fixed-gain warnings. The KEEL core reports
    HOLD once the gain is still, as for a fixed gain, so DC/profile/C-N
    gates behave the same.
    - The models bind to the KEEL-1 gain model (model_db_q8) and the startup
    noise map of the top row (gtab), and re-bind on a mode change, a
    retune/scan/calibration and a new gain table. One model at a time
    (union): +2.3 KB static RAM. Console T prints AGC model counters.
    - LEVEL learns the gain-model err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
    [agc.c, agc.h, calibration.c, diag.c, menu.c, receiver.c, receiver.h, test_agc_compare.c]
2026-10-25 REV B: R8 15k (D10) and R9 33k (D3) for the 8-bit DAC
    - Schematic, PCB (silkscreen value text) and BOM: R8 16k -> 15k,
    R9 32k -> 33k; R1-R7 and the 200 ohm load unchanged
    - Regenerate Gerbers, drills, gerber ZIP, schematic/fit-check PDFs,
    SVGs, DRC/ERC reports, the 3D top image and the three front renders
    with KiCad 10.0.7 using the previous export settings; copper, mask
    and drill data are unchanged apart from headers. STEP/GLB and back
    renders carry no resistor values and stay as they were
    - Update README, hardware README, AGENTS.md and FINDINGS.md values
    Claude-Session: https://claude.ai/code/session_017AWz9uZd39iY6CDkhsBZb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
    [BOM.csv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]
2026-10-25 Add C5VRX DIY REV C: 1N5819 Schottky diode replaces the SJ1 power jumper
    - New hardware/C5VRX_JACK_DIY_V3 (REV C), REV B left unchanged
    - D1 (1N5819, DO-41, lying flat between the jack and R9) feeds bay 5V to
    XIAO 5V, so USB and the goggle bay can be connected together
    - Project footprint with 1.7 mm pads / 1.0 mm drill so the courtyard
    fits; bay 5V moved to the front bottom edge, BIT 8 trace rerouted under
    D1, redundant GND via removed; rear marking REV C
    - KiCad 10.0.7: DRC 0 / unconnected 0 / parity 0, ERC 0; Gerbers, drills,
    PDFs, SVGs, STEP/GLB and renders regenerated
    - README (root and board) and BOM updated
    Claude-Sessio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
    [BOM.csv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]
2026-10-25 REV C: D1 on the R7 row, symmetric rear jumpers
    - D1 holes moved to y = 123 mm, the same row as R7's holes
    - SJ2 (BIT 7) moved to the R5 row, mirroring SJ3 (BIT 8) on the R3 row
    around the middle of the resistor bank; labels on the outside; BIT 7
    traces rerouted
    - Gerbers, drills, ZIPs, PDF, SVGs, STEP/GLB, renders and DRC/ERC
    regenerated (KiCad 10.0.7: DRC 0 / unconnected 0 / parity 0, ERC 0)
    - REV C README updated
    Claude-Session: https://claude.ai/code/session_017AWz9uZd39iY6CDkhsBZb6
    [C5VRX_JACK_DIY_V3-B_Cu.gbl, C5VRX_JACK_DIY_V3-B_Mask.gbs, C5VRX_JACK_DIY_V3-B_Paste.gbp, C5VRX_JACK_DIY_V3-B_Silkscreen.gbo, C5VRX_JACK_DIY_V3-Edge_Cuts.gm1, C5VRX_JACK_DIY_V3-F_Cu.gtl, C5VRX_JACK_DIY_V3-F_Mask.gts, C5VRX_JACK_DIY_V3-F_Paste.gtp]
2026-10-25 REV C: drop duplicate exports (SVGs, loose Gerbers)
    The loose Gerber/drill files are all in the Gerber ZIP, the schematic SVG
    duplicates the schematic PDF, and the top/bottom SVGs duplicate the
    Gerbers and renders. REV B keeps its files as merged.
    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
    [C5VRX_JACK_DIY_V3-B_Cu.gbl, C5VRX_JACK_DIY_V3-B_Mask.gbs, C5VRX_JACK_DIY_V3-B_Paste.gbp, C5VRX_JACK_DIY_V3-B_Silkscreen.gbo, C5VRX_JACK_DIY_V3-Edge_Cuts.gm1, C5VRX_JACK_DIY_V3-F_Cu.gtl, C5VRX_JACK_DIY_V3-F_Mask.gts, C5VRX_JACK_DIY_V3-F_Paste.gtp]
2026-10-25 Speed up startup calibration with verified search and full fallbacks
2026-10-25 Retain filter cadence and document calibration timing model
2026-10-25 Boot from baseline, calibrate on request and export verified board reports
2026-10-25 Keep proven calibration recommendations visible in the menu
2026-10-25 Recognize sustained DC offsets in low-gain dithered noise
    [calibration.c, test_manual_calibration_runtime.py, test_sphase_runtime.py]
2026-10-26 Add a VTX-on PHY sensitivity lab (console S) with test plan
    Extends the PR #254 VTX-off noise lab: the same reversible PHY settings,
    now with a weak VTX carrier present, scored on carrier and noise together.
    - docs/PHY_SENSITIVITY_LAB.md: candidate inventory (NF-auto, IQ
    correction, digital filter, packet/RX policy, clocks, ADC selector,
    LO cap, ULP, analog filter code, gain rows, DAC output), what is left
    out and why, metrics, safety design and the step-by-step test plan
    - main/sense_lab.c: bench-only console S + suite key; STOCK-TEST-TEST-
    STOCK at fixed gain/DC/frequency/filter with shams, 16 captures per
    stage, every write restored and verified (reboot on a failed restore),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
    [calibration.c, console.c, phy_sense_lab.py, sense_lab.c, sense_lab.h, sense_lab_logic.h, test_sense_lab_tool.py, test_sense_metrics.c]
2026-10-26 Sense lab: re-hold DC after paused gain writes; score video sync coverage
    - A paused gain write releases the DC hold and the post-gain hook is
    silent while paused: suite 8, the gain screen and the final gain
    restore lost the calibrated DC pair. calibration_dc_hold_current()
    re-holds it explicitly after every lab gain write.
    - tools/phy_sense_lab.py scores video_cov (captures with syncs): a TEST
    that loses sync is never BETTER on C/N or clicks alone (MIXED/WORSE).
    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
2026-10-26 fix(web): flash a running C5VRX-5 from the browser without the BOOT button
    Connect device used esptool.js's USB reset. On a running C5VRX-5 that
    reset reaches the CPU but not the modem, the ROM loader stops answering
    and the board hangs until it is power-cycled (the reason for console key
    ` and tools/enter_download.py, #175). Flashing needed BOOT held at
    power-up, and after flashing the RTS reset brought an ESP32-C5 back up
    in the loader instead of the new firmware.
    Connect now sends the download key first and waits for the restart; the
    loader then answers without any reset. The USB reset is kept for boards
    that do not answer the key (BOOT held, other firmware) and is never used
    after the f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
2026-10-26 tools: add flash.py, flash a running receiver without a USB line reset
    idf.py flash resets the C5 through DTR/RTS, which hangs a running
    C5VRX-5 (pySerial "Write timeout") until USB and battery are removed.
    flash.py sends the console download key, waits for the ROM loader and
    runs esptool with --before no-reset --after watchdog-reset. It refuses
    to flash when the firmware does not acknowledge the key, so no esptool
    sync reaches live firmware. README now points source builds at it.
    [enter_download.py, flash.py, test_flash_tool.py]
2026-10-26 tools/flash.py: add --app-only
    Flashes build/flash_app_args (the app image only) instead of the full
    set, so firmware-only changes skip the bootloader and partition table.
    The tool stops before the download key when that file is missing rather
    than falling back to the full set.
    [flash.py, test_flash_tool.py]
2026-10-26 tools/flash.py: add --monitor
    After a good flash, reopen the console with DTR and RTS low (set before
    the open, so no chip reset), print it at 115200 and send each key as
    typed, as the receiver console expects. It keeps reopening while the
    watchdog restart re-enumerates USB. Ctrl+] or Ctrl+C exits. This
    replaces idf.py flash monitor, whose monitor resets the chip through
    the same lines.
    [flash.py, test_flash_tool.py]
2026-10-26 test_flash_tool: run without pyserial
    CI runs the host tests with the container's plain python3, which has no
    pyserial. The monitor tests now swap in a stand-in serial module.
    [test_flash_tool.py]
2026-10-26 Stop the DC batch only on a definite carrier
    Quantized low-gain receiver noise (VTX off) lifted the envelope statistic
    above the quiet limit or read as origin, so every F ended at G68..G73 as
    carrier_detected with the low rows missing. Use the filter sweep's definite
    carrier rule for the DC batch and row repair, and log the gate reason.
    Board: 30/30 rows over three runs.
    [calibration.c, calibration_noise.h, test_calibration_noise.c]
2026-10-26 Hold a firmware DC base map for rows without own codes
    With the baseline filter a gain row without this board's own F codes now
    holds main/dco_preset.h instead of the chip's DC (3.7/1.7 cells at G83 on
    an uncalibrated board). The preset is the median of measured boards, built
    by tools/dco_preset.py from F + C reports and checked in CI; one board so
    far (nine F runs, three boot sessions). It is never an own row or
    calibration evidence; F replaces it.
    [calibration.c, calibration_policy.h, dco_preset.py]
2026-10-26 Tune DC live with a gated servo and repair the sampling phase
    - Base map: fill missing baseline rows in task context as template rows;
    the gain hook only reads RAM (the preset lookup in the hook left the USB
    console silent from boot).
    - Restore main's per-row live DC servo (VTX on/off, no video stop), state
    in LP RAM for 36 rows (5.2 KB more HP RAM silenced the console); adopt
    template/base-map rows held within 0.3 cells (8 noise / 16 carrier).
    - Servo corrects only on a settled sampling phase; recommend calibration
    only at its trim limit, without a row, after a fault or after 30 s of
    qualified DC above 1.5 cells (cal_persist_add).
    - Live sampling-phase repair: three monitor bloc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
    [calibration.c, calibration_policy.h, console.c, dc_servo.h, test_sphase_runtime.py]
2026-10-26 Record the wrong sampling phase, live servo and base map findings
2026-10-26 feat(c5vrx5): AFC on a two-line window, digital RX mode 12, VTX-on lab board results
    Board 2026-10-26 (5865 MHz, PAL, console S lab from #273):
    - AFC: one 4092-byte control descriptor (1.6 lines) holds a
    timing-confirmed B/W sync pair in only ~45 % of windows (replay of 30
    board IQ snapshots through afc2_measure; 8190 B: 30/30), so the AFC
    never locked and the narrow profile never engaged. The control loop
    now measures the AFC on the 8190-byte contiguous snapshot under the
    scheduler hold; gain observation keeps the descriptor.
    AFC2_MAX_SAMPLES 8192.
    - Digital RX filter mode 12 replaces mode 0: C/N +0.20/+0.28/+0.52 dB
    and fewer FM clicks in three lab runs (REPRODUCED_BETTER).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
    [afc.h, calibration.c, control.c, gain.h, phy.c, phy.h, receiver.c, rf.c]
2026-10-26 docs(c5vrx5): board check of the AFC window and mode 12; NTSC porch window finding
2026-10-26 Menu: FILTER (AUTO/XNARROW/NARROW/NORMAL/WIDE), CALIBRATE submenu, C/N and firmware; VIDEO follows sync (#280)
    * feat(c5vrx5): menu FILTER, CALIBRATE submenu, C/N, firmware; VIDEO follows sync
    - FILTER: AUTO / NARROW / NORMAL / WIDE for this boot (console f). The
    card shows the measured -3 dB width of the active filter, the class,
    the VTX deviation and the AFC state. Hold skips classes without a
    calibrated filter and DC table; a chosen class stays across channel
    changes and is not overridden by the profile logic.
    - CALIBRATE opens QUICK (console F) / FULL (console B: every filter
    class) / BACK. The list scrolls (nine rows visible) with a thin bar.
    - Live card: C/N in place of the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
    [calibration.c, calibration_policy.h, console.c, control.c, dco_preset.py, flight_log.py, flightlog.c]
2026-10-27 tools/flash.py: add --monitor-only, --log, --iq and --iq-every
    --monitor-only opens the reset-free console (DTR and RTS low before the
    open) without flashing, so idf.py monitor is never needed. No build or
    esptool is required for it.
    --log FILE appends every console line with a local timestamp, plus the
    keys sent and the tool's own notes as '#' lines, so a bench session
    leaves a record. field_diag_compare.py now strips that timestamp, so
    these logs compare directly (plain serial logs work as before). Console
    output goes through a small Console class that splits lines, so the log
    and the screen see the same text; a partial line (a prompt) is still
    shown when the port goes quiet.
    --iq DIR sa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
    [capture_iq_snapshot.py, field_diag_compare.py, flash.py, test_field_diag_compare.py, test_flash_tool.py]
2026-10-27 tools/flash.py: add --check
    After flashing, wait for CAL_BOOT and the boot phase, send T and D, and
    exit 1 if the board crashed or rebooted, runs a different image than the
    one flashed (FIRMWARE elf_sha256 prefix against the built ELF), reports
    transport faults or a filter that did not read back, or (with
    --expect-video) has no video. Settings left behind (fixed gain, not
    calibrated, sampling phase unverified) only warn. A boot loop is
    reported once per distinct line with a count. The last line is
    "CHECK result=pass|fail ..." with VIDEO_Q, gain and C/N for scripts.
    With --monitor-only it checks the running board without flashing,
    waiting for a boot or comparing the image.
    [flash.py, test_flash_tool.py]
2026-10-27 Heap low-water mark: heap_min in T, read by flash.py --check
    heap_internal and heap_largest are a reading at the moment of T. The
    boot peak is earlier: the menu splash holds its DMA descriptor chain
    (about 18 KB) while receiver_start creates the gain tasks, and on the
    board that leaves about 2.1 KB free (COM6, 2026-10-26, heap prints per
    boot stage), while T a few seconds later reads 17 KB largest.
    T now prints heap_min, heap_caps_get_minimum_free_size(MALLOC_CAP_INTERNAL),
    which keeps that low point. flash.py --check puts heap_largest and
    heap_min in the CHECK line and warns (does not fail) below --heap-warn
    (8192) and --heap-min-warn (1024). Firmware without heap_min still
    works. Board: h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
    [console.c, flash.py, test_flash_tool.py]
2026-10-27 flash.py: warn when sdkconfig differs from sdkconfig.defaults; boot heap finding
    ESP-IDF never reapplies sdkconfig.defaults to an existing sdkconfig. On
    2026-10-26 an sdkconfig generated before the defaults cut
    CONFIG_ESP_WIFI_STATIC_RX_BUFFER_NUM to 2 still had 4; esp_wifi_init
    took 3,440 bytes more, receiver_start could not create gain_fast, and
    the board boot-looped with ESP_ERR_NO_MEM.
    Before flashing, every value set in sdkconfig.defaults is compared with
    the build's config/sdkconfig.json (options the build does not have are
    skipped). A difference is printed and repeated as a CHECK warning; it
    does not stop the flash, since a changed option can be intended. The
    README says to delete sd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
    [flash.py, test_flash_tool.py]
2026-10-27 fix(tools): reject incomplete checks and bound monitor memory
    [flash.py, test_flash_tool.py]
2026-10-27 Map the XIAO's 8 MB PSRAM: boot heap_min 2.1 KB -> 14.6 KB
    The XIAO ESP32-C5 is an ESP32-C5HR8 with 8 MB of in-package PSRAM that
    no generation enabled. With it mapped (quad, 80 MHz, caps alloc only),
    ESP-IDF moves the Wi-Fi library's own .bss (16 KB) out of internal SRAM.
    On COM6, same source: heap_min 2,104 -> 14,564, free while the menu is
    open about 6.4 KB -> 18.9 KB, --check pass, no transport faults. Nothing
    else uses PSRAM yet, so the video path stays in internal SRAM.
    A board without PSRAM now panics at boot. The variant that tolerates one
    (Wi-Fi heap in PSRAM, IGNORE_NOTFOUND) reached only heap_min 6,348, and
    both together boot-looped. T prints heap_psram. FINDINGS has the table.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
2026-10-27 Move three cold buffers to PSRAM: heap_min 14.6 KB -> 22.0 KB
    The sense lab's profile list, the diag trace and the flight-log queue
    (7.4 KB) are only touched by tasks, never by DMA, an interrupt or a
    flash write, so they go to PSRAM with EXT_RAM_BSS_ATTR. On COM6:
    heap_min 14,576 -> 21,956, heap_internal 37,132 -> 44,512, largest
    block 17,408 -> 19,456, menu open and close with no faults.
    IQ snapshot buffers stay internal: copying 8 KiB into PSRAM missed the
    copy deadline (1 of 10 snapshots, against 19 of 20 into internal RAM),
    so CPU writes to PSRAM at 80 MHz are below about 16 MB/s. FINDINGS lists
    what stays internal and why.
    [diag.c, flightlog.c, sense_lab.c]
2026-10-27 FINDINGS: long IQ captures into PSRAM fail while RX runs
    Tried on COM6: a GDMA memory-to-memory copy of the RX ring into PSRAM
    reaches 20-22 MB/s against the 40 MB/s IQ stream, falls behind after
    16-24 KiB, and every capture adds an rx_overflow and a tx_empty because
    the PSRAM writes starve the RX DMA. CPU copies are below 16 MB/s, and
    120 MHz PSRAM does not build with this flash configuration. Recorded so
    nobody ships it; the capture code is not part of this change.
2026-10-27 fix(psram): keep standard image compatible and add opt-in XIAO build
    [console.c, firmware_input_hash.py, flash.py, test_flash_tool.py]
2026-10-27 fix(c5vrx5): DC rows no longer locked out at the range edge
    Blackbox 2026-10-27 (board b26ef545, A1, NTSC VTX, sessions 246-249):
    edge rows G73-G83 sat 2-4.4 cells off for tens of seconds and RECOVER
    lasted 3-10 s after each fade.
    - The hold guard released a railing row's DC pair and banned the row
    for 2-32 s, during which the servo skips it: a row the servo could
    trim fell back to the chip's own DC and stayed there. It now releases
    and bans only rows the servo cannot trim, and wakes the servo instead.
    - Sign-bit bracket: where the sign share saturates, the step doubles
    while the cloud stays on one side (8 -> 16 codes) and halves across
    zero to one code, where the row is held unti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
    [calibration.c, dc_servo.h, receiver.c, receiver.h, test_dc_servo.c]
2026-10-27 fix(c5vrx5): AFC porch window 1.2-3.6 us so NTSC can lock
    The 3.4-4.4 us window (set for PAL) reached NTSC active video: on the
    board's NTSC snapshots afc2_measure read the porch at -1019 kHz where
    the flat porch sits at -1248 (1.2-3.6 us), so a VTX ~230 kHz off read
    as centred and the AFC never locked. PAL lab snapshots: -1044 vs -1040
    kHz. 2.4 us spans 8.6 NTSC / 10.6 PAL subcarrier periods, so the burst
    averages out. The window stays overridable for replays.
    [afc.h]
2026-10-27 feat(c5vrx5): menu PHY FILT, digital RX filter mode 12/0/4/8
    Operator request: choose the digital RX filter mode in the menu for
    field A/B. This boot only (every boot starts 12, where the noise maps
    and C/N reference are measured), reapplied on every RF restore, read
    back, previous mode kept on a failed readback; the DC row sums restart
    on a change. Board: 0/4/8/12 applied and read back, back on 12.
    [control.c, menu.c, menu_ui.c, menu_ui.h, phy.c, phy.h, rf.c, test_dfilt_runtime.py]
2026-10-27 feat(c5vrx5): keep FILTER, PHY FILT and the GAIN model across reboots
    Operator request: menu settings must survive a reboot. A new NVS blob
    "prefs" holds the FILTER choice, the PHY FILT mode and the gain model,
    written only when changed and restored at boot after the profile boot
    (a class without its own calibrated DC table flies DEFAULT until it has
    one). Only the automatic gain models (AUTO/LEVEL/RSSI) are kept: MAX
    and fixed gains still return to AUTO at boot, as decided on 2026-10-20
    (a forgotten fixed gain costs range without a sign). Channel, VIDEO,
    OUTPUT and AFC were already kept. PHY FILT shows LAB off mode 12, where
    the noise maps are measured.
    test_settings.py: save, reboot, wear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
    [control.c, main.c, menu_ui.c, menu_ui.h, phy.h, profile.c, receiver.c, receiver.h]
2026-10-27 fix(c5vrx5): T DFILT want= shows the selected mode
    [calibration.c]
2026-10-27 LEVEL AGC: score rows with the measured demod quality
    The blackbox walk (sessions 245-249) showed KEEL-1 writing 10-30 times a
    second on a strong signal with 60-90 % video; ~7 ms of picture per write,
    no extra cost per fold. LEVEL now decides on a table measured with the
    bit-exact U80P64-R1 (1080 physical-ADC cases, C/N x total radius,
    research/level_quality_grid.py -> research/level_quality.py ->
    main/level_quality.h) instead of the hand-made formula, keeps 200 ms of
    level history, and counts a folded window at its own level (3 dB over when
    the carrier dominates).
    Host harness on the same table with the blackbox write cost: LEVEL 70.4,
    0.2 writes/s (KEEL-1 68.4, 4.6/s; best fixed row 70.7;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
    [agc.c, level_quality.py, level_quality_grid.py, test_agc_compare.c]
2026-10-27 LEVEL: fast history takes over on a jump (hand on the antenna)
    Board session 267 (hand on the antenna, -30..-60 dBm): with the 200 ms
    history alone LEVEL moved ~6 times a second and folded 8176 windows, video
    40-85 %. A second 20 ms history now restarts the slow one when their best
    rows are 9 dB apart (a jump, not fading). The harness gets hand-on-the-
    antenna scenarios (-25 dB, 40-250 ms spells): close hand 78.5 at 15.9
    writes/s (KEEL-1 78.5 at 29.2); overall 70.5 at 1.7 writes/s against 68.7
    at 6.1. T prints the jump count.
2026-10-27 GAIN: LEVEL is the default mode, KEEL-1 stays selectable as KEEL
    Operator decision 2026-10-27 after the hand-on-antenna board test (LEVEL
    with the jump history: video 78 % against 56 %; "KEEL regulates too
    much"). GAIN_MODE_DEFAULT = LEVEL for a boot without prefs and after MAX
    or a fixed gain; the menu/console cycle starts at LEVEL, then KEEL, RSSI,
    MAX, fixed. Mode codes are unchanged (prefs, flight log); AUTO (0) now
    shows as KEEL. T reports the live gain owner.
    [console.c, control.c, main.c, receiver.c, receiver.h, test_settings.py]
2026-10-27 DC: pin bank 1 per table, DC fault visible, rails from DC are no carrier
2026-10-28 Decode the DC words of an AGC memory row
    arc_gain_entry_dc() reads the bank-1 and bank-2 PBUS DC words that the
    vendor's phy_wr_rx_gain_mem packs into each AGC memory entry next to the
    RF/BB/fine codes. The host test checks the packing round trip (including
    the bank-2 I bit that lands in w0[31]) and that the 2026-10-21 board dump
    has the expected structure: one bank-1 pair per RF stage, one bank-2 pair
    per BB half.
2026-10-28 Watch the vendor bank-1 table and AGC memory (T BANK1_CHECK)
    Bank 1 of each row comes from phy_param+0x180 (7 frequency groups x 9 RF
    stages), written only by the boot RX DC calibration and reloaded into the
    AGC memory by every channel setup. The 245/224 seen after the 2026-10-27
    walk matches no entry of that table, so one of the two layers changed
    during the session. T now compares the table with a hash taken at boot
    and every AGC memory row with the table, and the console prints
    BANK1_CHECK CHANGED within 5 s when either moves. It reads one AGC row at
    a time and keeps only the hash, so the standard image loses 12 bytes of
    boot heap. FINDINGS gets the static and board evidence.
2026-10-28 Firmware: board pin maps in one pin table, and a 4 MB layout
    main/board.h holds a pin map per board (Seeed XIAO ESP32-C5, Espressif
    ESP32-C5-DevKitC-1, Waveshare ESP32-C5-Pico, NiceMCU ESP32-C5 Mini),
    chosen with the Kconfig option C5VRX-5 board; the XIAO map is unchanged
    and stays the default. Each map was checked against the vendor pinout or
    schematic. The selected map is one 32-byte table in the image
    (board_pins_t, g_board_pins) that the web flasher can find and rewrite;
    board_init() reads it once in app_main before any task, and the DAC, the
    IQ loopback and the menu button use it through board_pins().
    board_pins_problem() rejects maps that would break USB, the flash bus or
    the boot stra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
    [partitions_4mb.csv]
2026-10-28 Web flasher: board selection, chip detection, wiring pictures and custom pins
    The C5VRX-5 tab gets a Board list and a Flash and PSRAM list. After
    Connect the flasher reads the chip's package eFuse (in-package PSRAM) and
    the flash ID; Auto picks the PSRAM image when the chip has PSRAM and the
    largest flash layout that fits, among the images of the selected build.
    An image larger than the flash is refused before any download, and a
    PSRAM image on a chip without in-package PSRAM needs a confirmation.
    C5VRX-5 images keep their own flash size header.
    Each board is drawn with its headers in their real order: which pin gets
    which DAC resistor, the IQ loopback pins to leave free, power and GND,
    and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
2026-10-28 CI: build and publish an image per board and memory layout
    A boards matrix builds xiao-psram, xiao-4mb, devkitc, devkitc-psram, pico
    and nicemcu next to the standard XIAO image and publishes them as
    c5vrx5-<id>.app.bin and c5vrx5-<id>.full.bin; the XIAO files keep their
    names. The version moves to its own job so all builds share it, and the
    checksums are written after the board images join the release.
    test_boards.py checks that the firmware pins, the flasher's boards and
    layouts, the matrix, the overlays and the partition tables agree, and the
    pin rule cases run on the host.
2026-10-28 Docs: boards, images, custom pins and the pin table
    docs/BOARDS.md lists every board's pin map and why it differs, the
    images and their release files, how Auto chooses PSRAM, the pin editor
    and the pin table, how to build one image and how to add a board. Only
    the XIAO is board tested.
